bickZero93/ESP32-S3-Honeywell-HO-5500RE-Ventilator-Smart/docs/images/internal-installation.jpg

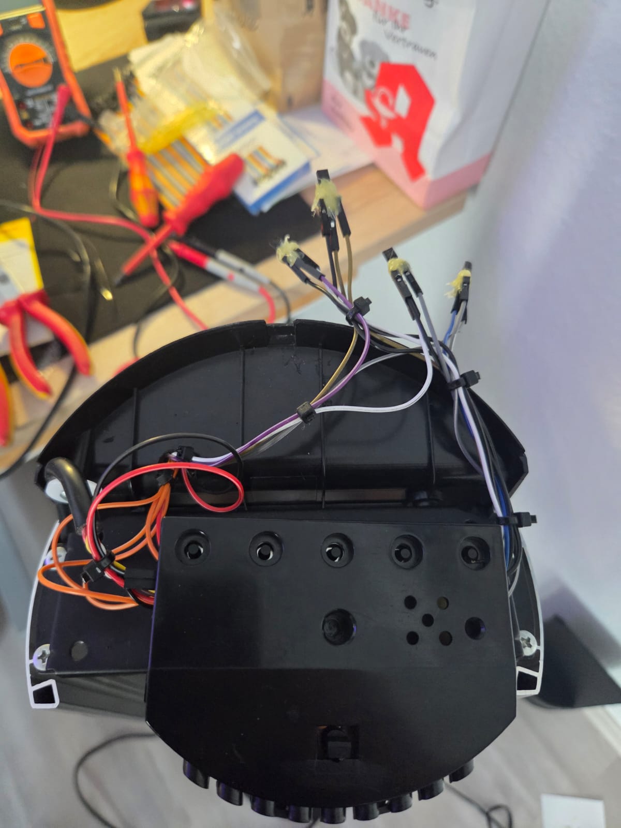
docs/images/internal-installation.jpg
