bickZero93/ESP32-S3-Honeywell-HO-5500RE-Ventilator-Smart/firmware/ventilator_esp32_s3_zero_FINAL_v6.4.10_UI_MANUAL_OSC.ino

// Smart-Ventilator / ESP32-S3-Zero
// Public GitHub build v6.4.10 - Zugangsdaten vor dem Flashen anpassen
//
// Hardware:
// GPIO6 -> 2N7000 Gate -> Taste 1 POWER    | GPIO7  <- LED Speed 1
// GPIO5 -> 2N7000 Gate -> Taste 2 SPEED    | GPIO8  <- LED Speed 2
// GPIO4 -> 2N7000 Gate -> Taste 3 OSC      | GPIO9  <- LED Speed 3
// GPIO3 -> 2N7000 Gate -> Taste 5 MODE     | GPIO10 <- LED Breeze
//                                          | GPIO1  <- LED Nacht
// Taste 4 (Original-Timer) wird NICHT benutzt.
//
// Reale Logik:
// POWER/0: normal AUS <-> AN behaelt Speed/Modus/Drehen der Fan-Platine.
// Nur nach kompletter Netztrennung startet das naechste EIN auf Speed1 / Normal / Drehen AUS.
// SPEED: 1 -> 2 -> 3 -> 1
// OSC: Toggle
// MODE: Normal -> Breeze -> Night -> Normal
//
// ACHTUNG:
// Wenn der ESP32 aus der Ventilatorplatine versorgt wird,
// USB NICHT anschliessen solange der Ventilator am Netz haengt.

#include <Arduino.h>
#include <WiFi.h>
#include <WebServer.h>
#include <Update.h>
#include <ESPmDNS.h>
#include <Preferences.h>
#include <LittleFS.h>
#include <stdarg.h>   // fuer anaSetAction (va_list)
#include <esp_system.h>

const char* WIFI_SSID = "YOUR_WIFI_SSID";
const char* WIFI_PASS = "YOUR_WIFI_PASSWORD";
const char* HOSTNAME  = "ventilator";
const char* FW_VERSION = "6.4.10-FINAL-UI-MANUAL-OSC";

// Fallback-AP, damit du dich auch bei WLAN-Problemen noch verbinden kannst.
// Wird NUR gestartet, wenn die WLAN-Verbindung fehlschlaegt (siehe startNetwork).
const char* AP_SSID = "Ventilator-Setup";
const char* AP_PASS = "CHANGE_ME_AP";   // >= 8 Zeichen, sonst bleibt der AP offen!

// Zugangsdaten fuer /update. Ohne diese koennte jeder im Netz beliebige
// Firmware aufspielen - inklusive jedem, der sich auf den Fallback-AP verbindet.
const char* OTA_USER = "admin";
const char* OTA_PASS = "CHANGE_ME_OTA";

// Belegung von unten nach oben, Taste und zugehoerige LED liegen sich
// auf dem ESP32-S3-Zero direkt gegenueber:
//   GP6 T1 Power   <->  GP7  LED Speed 1
//   GP5 T2 Speed   <->  GP8  LED Speed 2
//   GP4 T3 Drehen  <->  GP9  LED Speed 3
//   GP3 T5 Modus   <->  GP10 LED Breeze
//                       GP1  LED Nacht (links oben, ADC1 reicht nur bis GP10)
constexpr uint8_t PIN_POWER = 6;
constexpr uint8_t PIN_SPEED = 5;
constexpr uint8_t PIN_OSC   = 4;
constexpr uint8_t PIN_MODE  = 3;   // Strapping-Pin: 100k von Gate nach GND vorsehen

constexpr uint16_t PRESS_MS = 180;
constexpr uint16_t GAP_MS   = 260;

#define ENABLE_LED_FEEDBACK 1
#if ENABLE_LED_FEEDBACK
// Alle Feedback-Pins MUESSEN auf ADC1 liegen (GP1..GP10). ADC2 (ab GP11)
// ist bei aktivem WLAN vom Funkteil belegt und liefert keine Messwerte.
constexpr uint8_t PIN_LED1_FB = 7;   // LED1 ANODE / Speed 1
constexpr uint8_t PIN_LED2_FB = 8;   // LED2 ANODE / Speed 2
constexpr uint8_t PIN_LED3_FB = 9;   // LED3 ANODE / Speed 3
constexpr uint8_t PIN_LED8_FB = 10;  // Breeze
constexpr uint8_t PIN_LED9_FB = 1;   // Night
#endif

WebServer server(80);
Preferences prefs;

// Individuelle Schwellwerte fuer die 5 genutzten Feedback-LEDs.
// Reihenfolge: LED1, LED2, LED3, LED8, LED9
constexpr int FB_DEFAULT_THR[5] = {2368,3072,2432,3200,2752};
int fbThresholds[5] = {2368,3072,2432,3200,2752};

// Finale phasenunabhaengige ADC-Erfassung.
// Der alte feste Takt konnte sich mit dem LED-Multiplex synchronisieren.
// JITTER_V6 variiert Startphase, Kanalstart, Richtung, Zyklusabstand und Serienzeit.
// Die Zufallsfolge ist absichtlich nur pseudozufaellig: fuer Phasenentkopplung
// reicht das vollstaendig und die ADC-Messung bleibt frei von RNG-Nebenwirkungen.
constexpr uint8_t CAL_SAMPLER_VERSION = 6;
constexpr uint16_t PROFILE_SAMPLE_CYCLES = 480;
constexpr uint16_t PROFILE_JITTER_MIN_US = 80;
constexpr uint16_t PROFILE_JITTER_MAX_US = 420;

// FINAL_EFFICIENT_BALANCED_V6:
// Zehn feste, histogrammkompatible CDF-Schwellen pro Kanal. Ein einzelner
// Schwellwert bei ~3.1 V war in der realen Messung zu grob: mehrere 18P-
// Zustaende lagen trotz stabiler Einzelprofile fast uebereinander.
// Die 10 CDF-Stuetzstellen erfassen nun die VerteilungsFORM jedes LED-Signals.
constexpr uint8_t RICH_CDF_LEVELS = 10;
constexpr uint16_t RICH_CDF_ADC[RICH_CDF_LEVELS] = {
  1536,1792,2048,2304,2560,2816,3072,3328,3584,3840
};

// Mehrere kurze Jitter-Fenster werden absichtlich ueber einige Sekunden
// verteilt. Das mittelt Breeze/Night-Zyklen und mechanische Drehen-Effekte,
// statt zufaellig nur eine kurze Phase zu erwischen.
constexpr uint16_t PROFILE_SERIES_GAP_MIN_MS = 330;
constexpr uint16_t PROFILE_SERIES_GAP_MAX_MS = 620;

inline uint32_t profileRand32(uint32_t& x);

inline uint16_t profileSeriesGapMs(uint32_t& rng) {
  uint32_t r=profileRand32(rng);
  return PROFILE_SERIES_GAP_MIN_MS +
         (uint16_t)(r % (PROFILE_SERIES_GAP_MAX_MS-PROFILE_SERIES_GAP_MIN_MS+1));
}

inline uint32_t profileRand32(uint32_t& x) {
  x ^= x << 13;
  x ^= x >> 17;
  x ^= x << 5;
  if(x==0)x=0xA341316Cu;
  return x;
}

uint32_t profileSeedCounter=0x6D2B79F5u;

inline uint32_t profileNewSeed(uint32_t salt=0) {
  // Kein Hardware-RNG waehrend der ADC-Erfassung: wir brauchen keine
  // kryptographische Zufallsquelle, sondern nur immer neue Phasenlagen.
  profileSeedCounter += 0x9E3779B9u;
  uint32_t s=profileSeedCounter ^ (uint32_t)micros() ^
             ((uint32_t)millis()<<11) ^ salt;
  return profileRand32(s);
}

inline uint16_t profileJitterUs(uint32_t& rng) {
  uint32_t r=profileRand32(rng);
  return PROFILE_JITTER_MIN_US +
         (uint16_t)(r % (PROFILE_JITTER_MAX_US-PROFILE_JITTER_MIN_US+1));
}



struct FanState {
  uint8_t speed = 0;        // aktueller Zustand: 0=Aus, 1..3
  bool osc = false;
  uint8_t mode = 0;         // 0=Normal,1=Breeze,2=Night
  uint16_t sleepMin = 0;

  // Wird beim Ausschalten NICHT vergessen:
  uint8_t lastSpeed = 1;
  bool lastOsc = false;
  uint8_t lastMode = 0;
} state;

// Custom types bewusst sehr frueh deklarieren.
// Arduino erzeugt bei .ino-Dateien automatisch Funktionsprototypen; stehen
// solche Typen erst spaeter, kann daraus "'FbStats' does not name a type" werden.
struct FbStats {
  int minv;
  int maxv;
  int avg;
  int rangev;
  float abovePct;
  float belowPct;
  float cdfPct[RICH_CDF_LEVELS]; // Anteil >= RICH_CDF_ADC[q]
};

struct LearnedProfile {
  float avgPct[5];
  float avgMean[5];
  bool valid;
};

// -----------------------------------------------------------------
// ARDUINO-.INO-AUTOPROTOTYPE-FIREWALL
// Alle Funktionen mit eigenen Typen werden hier explizit deklariert.
// Dadurch muss der Arduino-Preprocessor fuer diese Signaturen KEINE
// automatischen Prototypen vor FbStats/LearnedProfile erzeugen.
// -----------------------------------------------------------------
inline void normalizedMeanFeature(const float meanv[5],float out[5]);
inline void normalizedMeanFeature(const FbStats cur[5],float out[5]);
inline float rawLevelFeature(const float meanv[5]);
inline float rawLevelFeature(const FbStats cur[5]);

bool addDiagnosticSampleAndAverage(const FbStats sample[5],
                                   FbStats avg[5],
                                   uint8_t minWindows);
void sampleProfileWindow(FbStats cur[5]);
void sampleProfileAverage(FbStats cur[5],uint8_t windows,uint16_t pauseMs);

bool learnProfile(LearnedProfile& p);
float currentNormalizedMean(const FbStats current[5],int ch);
float signatureDistanceWeighted(const LearnedProfile& sig,
                                const FbStats current[5],
                                const float weights[5]);
int detectProfilesWeightedFromCurrent(LearnedProfile profiles[3],
                                      const FbStats cur[5],
                                      const float weights[5],
                                      float* confidenceOut);
int detectProfilesFromCurrent(LearnedProfile profiles[3],
                              const FbStats cur[5],
                              float* confidenceOut);
int detectProfiles(LearnedProfile profiles[3],float* confidenceOut);
int detectCombo(const FbStats cur[5],
                int* speedOut,int* modeOut,
                float* speedConfOut,float* modeConfOut);
int detectComboOsc(const FbStats cur[5],
                   int* speedOut,int* modeOut,int* oscOut,
                   float* speedConfOut,float* modeConfOut,float* oscConfOut);
float comboDistanceToProfile(const LearnedProfile& p,const FbStats cur[5]);
float comboRichDistanceToState(int sp,int md,int os,const FbStats cur[5]);
float comboOscLinearScore(int sp,int md,const FbStats cur[5]);
int comboOscLinearDetect(int sp,int md,const FbStats cur[5],float* confidenceOut);
float comboPctShapeDistanceToProfile(const LearnedProfile& p,const FbStats cur[5]);
float comboPctShapeDistanceToSpeedMode(int sp,int md,const FbStats cur[5]);
int detectSpeedPctShapeForMode(int md,const FbStats cur[5],float* confidenceOut,float* fitOut);
int detectModePctShapeForSpeed(int sp,const FbStats cur[5],float* confidenceOut,float* fitOut);
void manualSyncAccumulateBatch(const FbStats cur[5],float pairDist[3][3],uint8_t speedVotes[3][3],uint8_t oscOnVotes[3][3],uint8_t oscOffVotes[3][3],float oscScoreSum[3][3]);
void detectContextual18(const FbStats cur[5],
                        int* sp,float* sc,int* md,float* mc,int* os,float* oc);
bool ledsLookOff(const FbStats cur[5]);
int anaClassifyStats(const FbStats cur[5],float* marginOut,float* fitOut);
bool anaSampleProfileAverageResponsive(FbStats cur[5],uint8_t windows,uint32_t salt);
void anaProfileRawMean(uint8_t c,float meanv[5]);

bool anaResponsiveDelay(unsigned long ms);
void anaServiceIo();
bool anaMoveToState(uint8_t sp,uint8_t md,bool os);

unsigned long timerDeadlineMs = 0;

uint32_t stateRevision=1;
uint32_t bootSessionId=0;

inline void bumpStateRevision() {
  stateRevision++;
  if(stateRevision==0)stateRevision=1;
}

uint32_t timerRemainingSec() {
  if(!timerDeadlineMs)return 0;
  long remain=(long)(timerDeadlineMs-millis());
  return remain>0?(uint32_t)((remain+999L)/1000L):0;
}


unsigned long lastWifiRetryMs = 0;

// Aktueller Power-Zustand getrennt von der gemerkten Geschwindigkeit.
bool fanIsOn = false;

// Direkt nach Power-EIN ist LED-Feedback besonders wichtig, um den vom
// Ventilator selbst gespeicherten Zustand wieder zu erkennen.
unsigned long startupSyncUntilMs = 0;
unsigned long startupSyncReadyMs = 0;
uint8_t startupSpeedCandidate = 0;
uint8_t startupSpeedHits = 0;
int8_t startupModeCandidate = -1;
uint8_t startupModeHits = 0;

bool manualLedSyncRequested = false;
bool suppressFanStateSave=false;   // nur waehrend finaler Analyse
bool suppressCalibrationSave=false; // beim atomaren Modellaufbau nur einmal am Ende schreiben

// LED-Erkennung ist reine Diagnose, ausser beim bewusst manuellen Sync.
// Nach Power-EIN warten wir, bis die Multiplexsignale stabil sind.
unsigned long ledDetectReadyMs = 0;
constexpr unsigned long LED_DETECT_SETTLE_MS = 5000UL;

int diagSpeedCandidate = 0;
uint8_t diagSpeedHits = 0;
int diagModeCandidate = -1;
uint8_t diagModeHits = 0;
int stableDiagSpeed = 0;
int stableDiagMode = -1;
float stableDiagSpeedConf = 0.0f;
float stableDiagModeConf = 0.0f;

int diagOscCandidate = -1;
uint8_t diagOscHits = 0;
int stableDiagOsc = -1;
float stableDiagOscConf = 0.0f;

constexpr uint8_t DIAG_ROLLING_WINDOWS = 10;
FbStats diagWindow[DIAG_ROLLING_WINDOWS][5];
uint8_t diagWindowCount=0;
uint8_t diagWindowPos=0;

bool diagCacheValid=false;
bool diagCachePctValid=false;
bool diagCacheOff=false;
int diagCacheSpeed=0;
int diagCacheMode=-1;
int diagCacheOsc=-1;
float diagCacheSpeedConf=0.0f;
float diagCacheModeConf=0.0f;
float diagCacheOscConf=0.0f;
float diagContextFit=0.0f;
float diagWebFit=0.0f;

// Globaler, kontextfreier 18P-Treffer.
int diagGlobalSpeed=0;
int diagGlobalMode=-1;
int diagGlobalOsc=-1;
float diagGlobalSpeedConf=0.0f;
float diagGlobalModeConf=0.0f;
float diagGlobalOscConf=0.0f;
float diagGlobalFit=0.0f;

float diagCachePct[5]={0,0,0,0,0};
unsigned long diagLastSampleMs=0;
unsigned long diagNextSampleMs=0;
uint32_t diagSeriesRng=0xD1A64C5Fu;
unsigned long diagCacheAtMs=0;
bool startupScanDone = false;

bool otaInProgress=false;
bool otaUploadSucceeded=false;


void saveFanState();

void loadFanState() {
  prefs.begin("fanstate", true);

  uint8_t savedSpeed=prefs.getUChar("lastSpeed",1);
  bool savedOsc=prefs.getBool("lastOsc",false);
  uint8_t savedMode=prefs.getUChar("lastMode",0);
  bool savedPower=prefs.getBool("powerOn",false);

  prefs.end();

  if(savedSpeed<1||savedSpeed>3)savedSpeed=1;
  if(savedMode>2)savedMode=0;

  esp_reset_reason_t reason=esp_reset_reason();
  bool realPowerCycle=(reason==ESP_RST_POWERON)||(reason==ESP_RST_BROWNOUT);

  state.sleepMin=0;
  timerDeadlineMs=0;

  if(realPowerCycle) {
    // Bei echter Netztrennung setzt auch die Ventilatorplatine zurueck:
    // physisch AUS; der naechste Start ist Stufe1 / Normal / Drehen AUS.
    fanIsOn=false;
    state.speed=0;
    state.osc=false;
    state.mode=0;
    state.lastSpeed=1;
    state.lastOsc=false;
    state.lastMode=0;
    saveFanState();
    Serial.println("[BOOT] echter Power-Cycle -> physisch AUS, Basis St1/Normal/Drehen AUS");
  } else {
    // Bei OTA-/Software-Neustart bleibt die Ventilatorplatine in Betrieb.
    // Deshalb muss nicht nur der letzte Modus, sondern auch EIN/AUS erhalten
    // bleiben; sonst wuerde die Weboberflaeche einen laufenden Fan als AUS zeigen.
    state.lastSpeed=savedSpeed;
    state.lastOsc=savedOsc;
    state.lastMode=savedMode;
    fanIsOn=savedPower;

    if(fanIsOn) {
      state.speed=savedSpeed;
      state.osc=savedOsc;
      state.mode=savedMode;
      Serial.printf("[BOOT] Software-Neustart -> Zustand erhalten: Stufe %u / Modus %u / Drehen %s\n",
                    state.speed,state.mode,state.osc?"AN":"AUS");
    } else {
      state.speed=0;
      state.osc=false;
      state.mode=0;
    }
  }
}

void saveFanState() {
  prefs.begin("fanstate",false);
  prefs.putUChar("lastSpeed",state.lastSpeed);
  prefs.putBool("lastOsc",state.lastOsc);
  prefs.putUChar("lastMode",state.lastMode);
  prefs.putBool("powerOn",fanIsOn);
  prefs.end();
}


#if ENABLE_LED_FEEDBACK
const uint8_t FB_USED_PINS[5] = {
  PIN_LED1_FB, PIN_LED2_FB, PIN_LED3_FB, PIN_LED8_FB, PIN_LED9_FB
};

LearnedProfile speedSig[3];  // Speed 1..3
LearnedProfile modeSig[3];   // Normal, Breeze, Night
// AUS wird gemessen statt geschaetzt. Bei gemultiplexten LEDs liegt der
// Aus-Pegel nicht zwingend weit genug unter den Ein-Profilen, deshalb
// reicht eine feste Prozentgrenze nicht aus.
LearnedProfile offSig;

// Neun Profile: eine eigene Signatur je Stufe/Modus-Kombination.
// Grund: Die Messung zeigt, dass sich das Muster eines Modus staerker
// zwischen den Stufen verschiebt (3,3) als Breeze von Nacht abweicht (0,3).
// Ein ueber die Stufen gemitteltes Modus-Profil passt damit zu keinem
// tatsaechlichen Zustand. comboSig[speed-1][mode] loest das.
LearnedProfile comboSig[3][3];

// Finale 18 Profile: Speed (3) x Modus (3) x Drehen (2).
// Der integrierte Drehen-Test hat gezeigt: 7/9 Zustaende wurden mit
// Drehen AN durch die alte 9-Profil-Erkennung falsch klassifiziert,
// groesster Driftfaktor 6.10. Deshalb ist Oscillation jetzt eine echte
// dritte Klassifikationsdimension und kein externer Diagnosetest mehr.
LearnedProfile comboOscSig[3][3][2];

bool calibrationSamplerCurrent=false; // nur FINAL_EFFICIENT_BALANCED_V6-Profile duerfen als aktuelle Generation gelten
bool compactComboLoaded = false;
bool compactComboLastSaveOk = false;

bool comboOscComplete() {
  for(int sp=0; sp<3; sp++)
    for(int md=0; md<3; md++)
      for(int os=0; os<2; os++)
        if(!comboOscSig[sp][md][os].valid) return false;
  return true;
}

uint8_t comboOscValidCount() {
  uint8_t n=0;
  for(int sp=0;sp<3;sp++)
    for(int md=0;md<3;md++)
      for(int os=0;os<2;os++)
        if(comboOscSig[sp][md][os].valid)n++;
  return n;
}

uint8_t comboValidCount() {
  uint8_t n=0;
  for(int sp=0;sp<3;sp++)
    for(int md=0;md<3;md++)
      if(comboSig[sp][md].valid)n++;
  return n;
}

// Diese beiden Flags muessen vor activeRecognitionModel() sichtbar sein.
bool comboRichValid=false;
bool comboGlobalSyncSafe=false;

const char* activeRecognitionModel() {
  if(!calibrationSamplerCurrent) return "NEUKALIBRIERUNG";
  if(comboOscComplete() && comboRichValid) return "FINAL_18P";
  if(comboValidCount()==9) return "FALLBACK_9P";
  return "EINZELPROFILE";
}

// Aus der Messung abgeleitete Kanalgewichte. Statt fester Zahlen bekommt
// jeder Kanal das Gewicht, das seinem Signal-Rausch-Verhaeltnis entspricht:
// Spannweite zwischen den Zustaenden geteilt durch die Streuung innerhalb
// eines Zustands. Kanaele, die nichts beitragen, fallen so von selbst weg.
float comboW[5] = {1.0f,1.0f,1.0f,1.0f,1.0f};
bool  comboWValid = false;

// Formanteil der Distanzberechnung (0 = nur Absolutpegel, 1 = nur Form).
// Hintergrund: Breeze und Nacht liegen im Pegel praktisch gleichauf, LED8
// ist im Nacht-Modus aber konsistent niedriger und LED9 hoeher. Diese
// Formdifferenz ueberlebt, wenn man den Mittelwert ueber alle Kanaele
// abzieht - und weil das Rauschen gemultiplexter LEDs weitgehend
// gleichtaktig ist, faellt es dabei mit heraus.
// Der Wert wird im Messlauf ermittelt, nicht geraten.
float comboShape = 0.0f;

// Zweites, explizit mitkalibriertes Merkmal: relative ADC-Mittelwerte.
// Diese Information ist besonders fuer die historisch enge Stufe-1/Stufe-3-
// Trennung nuetzlich. Anders als in alten 6.0.x-Versionen wird ihr Anteil
// NICHT geraten, sondern per Cross-Validation optimiert.
float comboMeanW[5]={1.0f,1.0f,1.0f,1.0f,1.0f};
float comboMeanAlpha=0.0f;

// 50 CDF-Merkmale (5 Kanaele x 10 Pegel), kompakt quantisierte 18P-Zentren.
// uint16_t speichert 0.01 Prozentpunkte (0..10000) ohne relevante Quantisierungsverluste.
float comboRichW[5][RICH_CDF_LEVELS] = {};
uint16_t comboRichPctQ[3][3][2][5][RICH_CDF_LEVELS] = {};
float comboLevelAlpha=0.0f;

// Dedizierter Drehen-Klassifikator V1.
// Der reale 6.4.3-Lauf zeigte: Speed und Modus sind mit dem Rich-Modell
// eindeutig, waehrend Drehen in Breeze/Nacht nicht durch eine gemeinsame
// 18P-Metrik stabil genug ist. Deshalb wird Drehen bei bekanntem Modus
// mode-uebergreifend ueber alle drei Stufen als lineares CDF-Modell erkannt.
// Features: 5 Kanaele x 10 CDF-Pegel + 3 Speed-One-Hot = 53.
constexpr uint8_t OSC_LINEAR_FEATURES=53;
int16_t comboOscLinW[3][OSC_LINEAR_FEATURES] = {};
float comboOscLinScale[3]={1.0f,1.0f,1.0f};
float comboOscLinBias[3]={0.0f,0.0f,0.0f};
bool comboOscLinValid=false;

// Normales Tracking ist bewusst kontextuell: Webzustand = autoritativ.
// Blindes 18P wird separat bewertet und nur fuer den manuellen 3/3-Sync
// freigeschaltet, wenn sein eigener Holdout stark genug ist.

inline uint16_t richEncodePct(float v) {
  return (uint16_t)constrain((int)lroundf(constrain(v,0.0f,100.0f)*100.0f),0,10000);
}
inline float richDecodePct(uint16_t q) {
  return ((float)q)*0.01f;
}
inline float rawLevelFeature(const float meanv[5]) {
  float s=0.0f;
  for(int ch=0;ch<5;ch++)s+=constrain(meanv[ch],0.0f,4095.0f);
  return s*(100.0f/(5.0f*4095.0f));
}
inline float rawLevelFeature(const FbStats cur[5]) {
  float m[5];
  for(int ch=0;ch<5;ch++)m[ch]=(float)cur[ch].avg;
  return rawLevelFeature(m);
}

// Typischer maximaler Abstand eines korrekten Holdout-Treffers.
// Laufzeitmessungen weit ausserhalb dieses Bereichs werden als
// "ausserhalb Kalibrierung" erkannt statt mit hoher Scheinsicherheit.
float comboFitLimit=12.0f;

// Merkmalsvektor: f = pct - shape * Mittelwert(pct). shape=0 laesst den
// Absolutpegel unveraendert, shape=1 zentriert vollstaendig auf die Form.
inline void comboFeature(const float pct[5], float shape, float out[5]) {
  float m = 0.0f;
  for(int i=0;i<5;i++) m += pct[i];
  m /= 5.0f;
  for(int i=0;i<5;i++) out[i] = pct[i] - shape * m;
}


inline void normalizedMeanFeature(const float meanv[5],float out[5]) {
  float sum=0.0f;
  for(int ch=0;ch<5;ch++)sum+=max(meanv[ch],0.0f);
  if(sum<1.0f)sum=1.0f;
  for(int ch=0;ch<5;ch++)out[ch]=meanv[ch]*100.0f/sum;
}

inline void normalizedMeanFeature(const FbStats cur[5],float out[5]) {
  float m[5];
  for(int ch=0;ch<5;ch++)m[ch]=(float)cur[ch].avg;
  normalizedMeanFeature(m,out);
}



// Vorwaertsdeklaration bewusst vor allen Kalibrierungs-Save-Helfern.
bool saveCompactComboCalibration(bool reclaimLegacy=true);

void loadFeedbackThresholds() {
  prefs.begin("fanfb", true);
  for(int i=0;i<5;i++) {
    String key = "th" + String(i);
    fbThresholds[i] = prefs.getInt(key.c_str(), FB_DEFAULT_THR[i]);
  }
  prefs.end();
}

void saveFeedbackThreshold(int index,int value) {
  if(index<0||index>=5)return;
  fbThresholds[index]=constrain(value,0,4095);

  if(!suppressCalibrationSave)
    saveCompactComboCalibration(false);
}
#endif

// Explizite Deklarationen verhindern Probleme mit der Arduino-.ino-Autoprototypisierung.
bool learnProfile(LearnedProfile& p);
bool learnSpeedSignature(int speedNo);

// true, solange ein manueller Lernvorgang laeuft. Verhindert, dass Analyse und
// Einzel-Lernen gleichzeitig den Ventilator steuern und messen.
bool learnBusy = false;
bool learnModeSignature(int modeNo);
bool loadCompactComboCalibration();
bool saveCompactComboCalibration(bool reclaimLegacy);
void clearCompactComboCalibration();
void resetStableDiagnostic();
void armLedDiagnostic(unsigned long settleMs);
void resetDiagnosticWindow();
bool addDiagnosticSampleAndAverage(const FbStats sample[5], FbStats avg[5], uint8_t minWindows);
void sampleProfileWindow(FbStats cur[5]);
void sampleProfileAverage(FbStats cur[5], uint8_t windows, uint16_t pauseMs);
void updateLedDiagnosticTask();
void invalidateRuntimeCalibrationForSampler();
bool anaResponsiveDelay(unsigned long ms);
bool anaNormalizePhysicalBaseline(String& err);
void detectContextual18(const FbStats cur[5], int* sp,float* sc,int* md,float* mc,int* os,float* oc);
float signatureDistance5(const LearnedProfile& sig, const FbStats current[5]);
int detectProfiles(LearnedProfile profiles[3], float* confidenceOut);
int detectProfilesFromCurrent(LearnedProfile profiles[3], const FbStats cur[5], float* confidenceOut);
float normalizedMean(const float means[5], int ch);
float currentNormalizedMean(const FbStats current[5], int ch);
float signatureDistanceWeighted(const LearnedProfile& sig, const FbStats current[5], const float weights[5]);
float comboDistanceToProfile(const LearnedProfile& p,const FbStats cur[5]);
float comboFitQualityPct(float distanceSq);
float comboPctShapeDistanceToProfile(const LearnedProfile& p,const FbStats cur[5]);
float comboPctShapeDistanceToSpeedMode(int sp,int md,const FbStats cur[5]);
int detectSpeedPctShapeForMode(int md,const FbStats cur[5],float* confidenceOut,float* fitOut);
int detectModePctShapeForSpeed(int sp,const FbStats cur[5],float* confidenceOut,float* fitOut);
void manualSyncAccumulateBatch(const FbStats cur[5],float pairDist[3][3],uint8_t speedVotes[3][3],uint8_t oscOnVotes[3][3],uint8_t oscOffVotes[3][3],float oscScoreSum[3][3]);
void resetDiagnosticWindow() {
  diagWindowCount=0;
  diagWindowPos=0;
}

bool addDiagnosticSampleAndAverage(const FbStats sample[5],
                                   FbStats avg[5],
                                   uint8_t minWindows) {
  minWindows=constrain(minWindows,(uint8_t)1,(uint8_t)DIAG_ROLLING_WINDOWS);

  for(int ch=0;ch<5;ch++)diagWindow[diagWindowPos][ch]=sample[ch];
  diagWindowPos=(diagWindowPos+1)%DIAG_ROLLING_WINDOWS;
  if(diagWindowCount<DIAG_ROLLING_WINDOWS)diagWindowCount++;

  if(diagWindowCount<minWindows)return false;

  // Exakt die letzten mode-/osc-abhaengigen Fenster mitteln.
  uint8_t start=(uint8_t)((diagWindowPos+DIAG_ROLLING_WINDOWS-minWindows)%DIAG_ROLLING_WINDOWS);

  for(int ch=0;ch<5;ch++) {
    double mean=0.0,pct=0.0;
    double cdf[RICH_CDF_LEVELS] = {};
    int minv=4095,maxv=0;

    for(uint8_t k=0;k<minWindows;k++) {
      uint8_t i=(uint8_t)((start+k)%DIAG_ROLLING_WINDOWS);
      mean+=diagWindow[i][ch].avg;
      pct+=diagWindow[i][ch].abovePct;
      for(int q=0;q<RICH_CDF_LEVELS;q++)cdf[q]+=diagWindow[i][ch].cdfPct[q];
      if(diagWindow[i][ch].minv<minv)minv=diagWindow[i][ch].minv;
      if(diagWindow[i][ch].maxv>maxv)maxv=diagWindow[i][ch].maxv;
    }

    avg[ch].avg=(int)(mean/minWindows+0.5);
    avg[ch].abovePct=(float)(pct/minWindows);
    avg[ch].belowPct=100.0f-avg[ch].abovePct;
    for(int q=0;q<RICH_CDF_LEVELS;q++)avg[ch].cdfPct[q]=(float)(cdf[q]/minWindows);
    avg[ch].minv=minv;
    avg[ch].maxv=maxv;
    avg[ch].rangev=maxv-minv;
  }
  return true;
}

// Laufzeitmessung passend zur FINAL_EFFICIENT_BALANCED_V6-Kalibrierung.
// Kalibrierung und Runtime nutzen dieselbe phasenentkoppelte Verteilung.
void sampleProfileWindow(FbStats cur[5]) {
  const uint8_t pins[5]={
    PIN_LED1_FB,PIN_LED2_FB,PIN_LED3_FB,PIN_LED8_FB,PIN_LED9_FB
  };

  double sum[5]={0,0,0,0,0};
  uint32_t above[5]={0,0,0,0,0};
  uint32_t richAbove[5][RICH_CDF_LEVELS] = {};
  int minv[5]={4095,4095,4095,4095,4095};
  int maxv[5]={0,0,0,0,0};

  uint32_t rng=profileNewSeed(0x13579BDFu);
  delayMicroseconds((uint16_t)(profileRand32(rng)%2001u)); // zufaellige Startphase

  for(int i=0;i<PROFILE_SAMPLE_CYCLES;i++) {
    uint32_t r=profileRand32(rng);
    int first=(int)(r%5u);
    int dir=(r&0x100u)?1:-1;

    for(int j=0;j<5;j++) {
      int ch=(first + dir*j + 10)%5;

      // Erste ADC-Lesung nach MUX-Wechsel bewusst verwerfen.
      (void)analogRead(pins[ch]);
      int v=constrain(analogRead(pins[ch]),0,4095);

      sum[ch]+=v;
      if(v>=fbThresholds[ch])above[ch]++;
      for(int q=0;q<RICH_CDF_LEVELS;q++)
        if(v>=RICH_CDF_ADC[q])richAbove[ch][q]++;
      if(v<minv[ch])minv[ch]=v;
      if(v>maxv[ch])maxv[ch]=v;
    }

    delayMicroseconds(profileJitterUs(rng));
  }

  for(int ch=0;ch<5;ch++) {
    cur[ch].avg=(int)(sum[ch]/PROFILE_SAMPLE_CYCLES+0.5);
    cur[ch].abovePct=above[ch]*100.0f/PROFILE_SAMPLE_CYCLES;
    cur[ch].belowPct=100.0f-cur[ch].abovePct;
    for(int q=0;q<RICH_CDF_LEVELS;q++)
      cur[ch].cdfPct[q]=richAbove[ch][q]*100.0f/PROFILE_SAMPLE_CYCLES;
    cur[ch].minv=minv[ch];
    cur[ch].maxv=maxv[ch];
    cur[ch].rangev=maxv[ch]-minv[ch];
  }
}

void sampleProfileAverage(FbStats cur[5], uint8_t windows, uint16_t pauseMs) {
  windows=constrain(windows,(uint8_t)1,(uint8_t)10);

  double sumMean[5]={0,0,0,0,0};
  double sumPct[5]={0,0,0,0,0};
  double sumCdf[5][RICH_CDF_LEVELS] = {};
  int minv[5]={4095,4095,4095,4095,4095};
  int maxv[5]={0,0,0,0,0};

  for(uint8_t w=0;w<windows;w++) {
    FbStats one[5];
    sampleProfileWindow(one);

    for(int ch=0;ch<5;ch++) {
      sumMean[ch]+=one[ch].avg;
      sumPct[ch]+=one[ch].abovePct;
      for(int q=0;q<RICH_CDF_LEVELS;q++)sumCdf[ch][q]+=one[ch].cdfPct[q];
      if(one[ch].minv<minv[ch])minv[ch]=one[ch].minv;
      if(one[ch].maxv>maxv[ch])maxv[ch]=one[ch].maxv;
    }

    if(w+1<windows) {
      delay(pauseMs);
      yield();
    }
  }

  for(int ch=0;ch<5;ch++) {
    cur[ch].avg=(int)(sumMean[ch]/windows+0.5);
    cur[ch].abovePct=sumPct[ch]/windows;
    cur[ch].belowPct=100.0f-cur[ch].abovePct;
    for(int q=0;q<RICH_CDF_LEVELS;q++)cur[ch].cdfPct[q]=sumCdf[ch][q]/windows;
    cur[ch].minv=minv[ch];
    cur[ch].maxv=maxv[ch];
    cur[ch].rangev=maxv[ch]-minv[ch];
  }
}


int detectLearnedSpeed(float* confidenceOut=nullptr);
int detectLearnedMode(float* confidenceOut=nullptr);
bool ledsLookOff(const FbStats cur[5]);

static const char PAGE[] PROGMEM = R"HTML(
<!DOCTYPE html><html lang="de"><head>
<meta charset="utf-8"><meta name="viewport" content="width=device-width,initial-scale=1,viewport-fit=cover">
<meta name="theme-color" content="#0d1116"><title>Ventilator</title>
<style>
:root{--bg:#0d1116;--card:#161c24;--line:#232c38;--txt:#e8edf3;--dim:#78889c;--air:#4fd1c5}
*{box-sizing:border-box;-webkit-tap-highlight-color:transparent}
body{margin:0;min-height:100dvh;background:var(--bg);color:var(--txt);
 font:400 17px/1.4 ui-rounded,-apple-system,"Segoe UI",Roboto,sans-serif;
 padding:24px 22px}
.wrap{width:100%;max-width:380px;margin:0 auto;display:flex;flex-direction:column;gap:16px}
h1{margin:0;font-size:13px;letter-spacing:.22em;text-transform:uppercase;color:var(--dim);font-weight:600}

/* ---------- Ventilator-Grafik ---------- */
.stage{position:relative;display:grid;place-items:center;padding:4px 0 0}
#fanart{width:100%;max-width:230px;height:auto;overflow:visible}
#fanart .guard{fill:none;stroke:var(--line);stroke-width:2}
#fanart .g2{stroke-width:1.2;opacity:.7}
#fanart .g3{stroke-width:1;opacity:.45}
#fanart .cage{fill:none;stroke:var(--line);stroke-width:1;opacity:.35}
#fanart .blade{fill:var(--air);fill-opacity:.13;stroke:var(--air);stroke-width:1.6;
 stroke-linejoin:round;transition:fill-opacity .3s,stroke-opacity .3s}
#fanart .hub{fill:var(--card);stroke:var(--air);stroke-width:2}
#fanart .hubdot{fill:var(--air)}
#fanart .stand{stroke:var(--line);stroke-width:5;stroke-linecap:round;fill:none}
#fanart .base{fill:var(--card);stroke:var(--line);stroke-width:2}
#fanart .w{fill:none;stroke:var(--air);stroke-width:2.5;stroke-linecap:round;opacity:0}

/* Rotor */
#blades{transform-origin:100px 92px;animation:spin var(--spin,1s) linear infinite;animation-play-state:paused}
@keyframes spin{to{transform:rotate(360deg)}}
/* Schwenken */
#head{transform-origin:100px 156px;animation:sway 7s ease-in-out infinite;animation-play-state:paused}
@keyframes sway{0%,100%{transform:rotate(-17deg)}50%{transform:rotate(17deg)}}
/* Luftstrom */
@keyframes gust{0%{opacity:0;transform:translateX(-10px) scaleX(.7)}
 25%{opacity:var(--wo,.8)}100%{opacity:0;transform:translateX(22px) scaleX(1.15)}}

#fanart[data-speed="1"]{--spin:1.15s;--gust:1.5s;--wo:.45}
#fanart[data-speed="2"]{--spin:.62s;--gust:1s;--wo:.7}
#fanart[data-speed="3"]{--spin:.3s;--gust:.62s;--wo:1}
#fanart:not([data-speed="0"]) #blades{animation-play-state:running}
#fanart[data-osc="1"] #head{animation-play-state:running}
#fanart[data-speed="0"] .blade{fill-opacity:.05;stroke-opacity:.4}
#fanart:not([data-speed="0"]) .w{animation:gust var(--gust) ease-out infinite}
#fanart .w2{animation-delay:.18s}
#fanart .w3{animation-delay:.36s}
#fanart[data-speed="1"] .w3{display:none}
@media(prefers-reduced-motion:reduce){
 #blades,#head,#fanart .w{animation:none!important}
 #fanart:not([data-speed="0"]) .w{opacity:var(--wo)}
}

/* Modus-Effekte */
#fanart[data-mode="breeze"] g.wind{animation:breathe 4.5s ease-in-out infinite}
@keyframes breathe{0%,100%{opacity:.25}45%{opacity:1}}
#fanart[data-mode="night"]{filter:brightness(.68) saturate(.75)}

/* ---------- Bedienung ---------- */
.seg{margin-top:12px;display:grid;grid-template-columns:repeat(3,1fr);gap:6px;background:var(--card);
 border:1px solid var(--line);border-radius:20px;padding:6px;transition:opacity .2s}
.seg.off{opacity:.4}
.seg button{border:none;background:none;color:var(--dim);font:600 14px/1 inherit;
 padding:12px 4px;border-radius:15px;cursor:pointer;transition:.18s}
.seg button.on{background:var(--air);color:#06231f}
.seg button:disabled{cursor:default}
.dial{display:grid;grid-template-columns:repeat(4,1fr);gap:10px;margin-bottom:2px}
.dial button{aspect-ratio:1;border:1px solid var(--line);border-radius:20px;background:var(--card);
 color:var(--dim);font:600 26px/1 inherit;display:grid;place-content:center;gap:6px;transition:.18s;cursor:pointer}
.dial button span{font-size:10px;letter-spacing:.14em;text-transform:uppercase}
.dial button.on{background:var(--air);border-color:var(--air);color:#06231f;box-shadow:0 0 26px -6px var(--air)}
.dial button:active{transform:scale(.94)}
.dial button:disabled{opacity:.5;cursor:default}
.row{display:flex;align-items:center;justify-content:space-between;gap:16px;
 background:var(--card);border:1px solid var(--line);border-radius:20px;padding:14px 20px}
.row small{display:block;color:var(--dim);font-size:13px;margin-top:2px}
.sw{width:62px;height:34px;flex:0 0 auto;border:none;border-radius:17px;background:var(--line);position:relative;transition:.2s;cursor:pointer}
.sw::after{content:"";position:absolute;top:4px;left:4px;width:26px;height:26px;border-radius:50%;background:var(--txt);transition:.2s}
.sw.on{background:var(--air)}.sw.on::after{left:32px;background:#06231f}
.sw:disabled{opacity:.35;cursor:default}

.timer{background:var(--card);border:1px solid var(--line);border-radius:20px;padding:14px 20px 8px;transition:opacity .2s}
.timer.off{opacity:.4}
.thead{display:flex;align-items:baseline;justify-content:space-between;gap:12px}
.tval{font:600 30px/1 inherit;font-variant-numeric:tabular-nums;color:var(--dim);transition:color .2s;white-space:nowrap}
.tval.on{color:var(--air)}
.tval em{font-style:normal;font-size:14px;font-weight:400;margin-left:3px;color:var(--dim)}
.trest{color:var(--dim);font-size:13px;margin-top:2px}
input[type=range]{-webkit-appearance:none;appearance:none;width:100%;margin:8px 0 0;height:34px;background:transparent;cursor:pointer}
input[type=range]:disabled{cursor:default}
input[type=range]::-webkit-slider-runnable-track{height:8px;border-radius:4px;background:var(--trk,var(--line))}
input[type=range]::-moz-range-track{height:8px;border-radius:4px;background:var(--trk,var(--line))}
input[type=range]::-webkit-slider-thumb{-webkit-appearance:none;width:26px;height:26px;margin-top:-9px;border-radius:50%;
 background:var(--knob,var(--dim));border:4px solid var(--card);box-shadow:0 2px 10px #0009;transition:transform .12s}
input[type=range]::-moz-range-thumb{width:26px;height:26px;border-radius:50%;border:4px solid var(--card);
 background:var(--knob,var(--dim));box-shadow:0 2px 10px #0009}
input[type=range]:active::-webkit-slider-thumb{transform:scale(1.18)}
.ticks{display:flex;justify-content:space-between;font-size:11px;color:var(--dim);
 letter-spacing:.06em;padding:0 2px 4px;font-variant-numeric:tabular-nums}
.sync{border:none;background:none;color:var(--dim);font:inherit;font-size:13px;text-decoration:underline;padding:2px;cursor:pointer}
.demo{border-top:1px dashed var(--line);padding-top:12px;color:var(--dim);font-size:12px;line-height:1.7}
.demo b{color:var(--txt);font-weight:600}
.demo label{display:flex;align-items:center;gap:8px;margin-top:6px;cursor:pointer}
.demo input{accent-color:var(--air);width:16px;height:16px}

/* ---------- ESP32 / Netzwerk / OTA ---------- */
.statusbar{display:flex;align-items:center;justify-content:space-between;gap:10px;
 background:var(--card);border:1px solid var(--line);border-radius:16px;padding:10px 14px;
 color:var(--dim);font-size:12px}
.statusleft,.statusright{display:flex;align-items:center;gap:8px}
.dot{width:8px;height:8px;border-radius:50%;background:var(--dim);box-shadow:0 0 0 3px #0002}
.dot.ok{background:var(--air)} .dot.err{background:#ff7373}
.badge{border:1px solid var(--line);border-radius:999px;padding:3px 8px;font-size:11px}
nav.tabs{display:grid;grid-template-columns:1fr 1fr;gap:6px;background:var(--card);
 border:1px solid var(--line);border-radius:18px;padding:5px;margin:14px 0 4px;position:sticky;top:8px;z-index:5}
nav.tabs button{border:none;background:none;color:var(--dim);font:600 14px/1 inherit;
 padding:12px 4px;border-radius:13px;cursor:pointer;transition:.18s}
nav.tabs button.on{background:var(--air);color:#06231f}
section[hidden]{display:none}
#viewCfg:not([hidden]){display:flex;flex-direction:column;gap:14px}
#viewMain:not([hidden]){display:block}
a.panellink{display:flex;align-items:center;justify-content:space-between;gap:12px;
 background:var(--card);border:1px solid var(--line);border-radius:20px;padding:16px;
 color:var(--txt);text-decoration:none;font-weight:600;font-size:15px}
a.panellink span{color:var(--dim);font-weight:400;font-size:13px;display:block;margin-top:3px}
a.panellink i{color:var(--air);font-style:normal;font-size:20px}
.dial button.on:disabled,.seg button.on:disabled{opacity:1}
.dial button.pending,.seg button.pending,.sw.pending{animation:pend 1.1s ease-in-out infinite}
@keyframes pend{50%{opacity:.55}}
details.panel{background:var(--card);border:1px solid var(--line);border-radius:20px;padding:0 16px;
 overflow:hidden;flex:0 0 auto}
details.panel>summary{cursor:pointer;list-style:none;padding:14px 0;font-size:14px;font-weight:600}
details.panel>summary::-webkit-details-marker{display:none}
.panelbody{border-top:1px solid var(--line);padding:12px 0 15px;color:var(--dim);font-size:13px}
.grid2{display:grid;grid-template-columns:1fr 1fr;gap:8px}
.kv{background:#10161d;border:1px solid var(--line);border-radius:13px;padding:9px 10px}
.kv b{display:block;color:var(--txt);font-size:12px;margin-bottom:2px}
.mini{border:1px solid var(--line);background:#10161d;color:var(--txt);border-radius:10px;padding:7px 10px;font:inherit;font-size:12px;cursor:pointer}
.upload{display:flex;gap:8px;align-items:center;flex-wrap:wrap;margin-top:10px}
.upload input[type=file]{max-width:100%;font-size:12px}
.note{font-size:11px;line-height:1.45;color:var(--dim);margin-top:8px}
.warn{border:1px solid #805f27;background:#2a2114;border-radius:14px;padding:10px 12px;color:#d8c18c;font-size:11px;line-height:1.45}

/* ---------- Manuelle Web-Status-Korrektur ---------- */
.manual-card{background:var(--card);border:1px solid var(--line);border-radius:20px;overflow:hidden}
.manual-details>summary{list-style:none;cursor:pointer;display:flex;align-items:flex-start;
 justify-content:space-between;gap:12px;padding:15px}
.manual-details>summary::-webkit-details-marker{display:none}
.manual-details>summary::after{content:"⌄";color:var(--dim);font-size:18px;line-height:1;
 margin-left:6px;transition:.18s}
.manual-details[open]>summary::after{transform:rotate(180deg)}
.manual-details>summary b{font-size:14px}
.manual-details>summary span{display:block;color:var(--dim);font-size:11px;margin-top:2px}
.manual-status{color:var(--air)!important;font-size:11px!important;white-space:nowrap;
 padding-top:2px;margin-left:auto}
.manual-body{border-top:1px solid var(--line);padding:12px 15px 15px}
.manual-buttons{display:grid;grid-template-columns:repeat(4,1fr);gap:7px}
.manual-buttons button,.manual-modes button{border:1px solid var(--line);background:#10161d;color:var(--txt);
 border-radius:12px;padding:11px 4px;font:600 12px/1 inherit;cursor:pointer}
.manual-buttons button.on,.manual-modes button.on{background:var(--air);border-color:var(--air);color:#06231f}
.manual-buttons button:disabled,.manual-modes button:disabled{opacity:.5;cursor:default}
.manual-buttons button:active,.manual-modes button:active{transform:scale(.97)}
.manual-mode-label{margin:12px 2px 7px;color:var(--dim);font-size:11px;text-transform:uppercase;
 letter-spacing:.12em}
.manual-modes{display:grid;grid-template-columns:repeat(3,1fr);gap:7px}
.manual-osc-row{display:flex;align-items:center;justify-content:space-between;gap:14px;
 background:#10161d;border:1px solid var(--line);border-radius:12px;padding:10px 12px}
.manual-osc-row b{display:block;color:var(--txt);font-size:12px}
.manual-osc-row span{display:block;color:var(--dim);font-size:10px;margin-top:2px}
.sync-wide{width:100%;padding:12px 14px;border-radius:13px;font-weight:600}

/* ---------- Einstellungen kompakt gruppiert ---------- */
.grouped-tools{display:flex;flex-direction:column;gap:10px}
.tool-block{background:#10161d;border:1px solid var(--line);border-radius:14px;padding:11px}
.tool-head{display:flex;align-items:center;justify-content:space-between;gap:12px}
.tool-head b{display:block;color:var(--txt);font-size:13px}
.tool-head span{display:block;color:var(--dim);font-size:11px;margin-top:2px}
.tool-link{color:inherit;text-decoration:none}
.calibration-subpanel{padding:0;overflow:hidden}
.calibration-subpanel>summary{list-style:none;cursor:pointer;padding:11px}
.calibration-subpanel>summary::-webkit-details-marker{display:none}
.calibration-subpanel>summary::after{content:"⌄";color:var(--dim);font-size:18px;margin-left:8px}
.calibration-subpanel[open]>summary::after{transform:rotate(180deg)}
.calibration-subpanel>.note{padding:0 11px}
.calibration-subpanel>.panelbody{margin:0 11px;padding-bottom:11px}

</style></head><body>
<div class="wrap">
<h1 id="hdr">Aus</h1>
<div class="statusbar">
 <div class="statusleft"><span class="dot" id="connDot"></span><span id="connTxt">ESP32 wird gesucht…</span></div>
 <div class="statusright"><span class="badge" id="fwBadge">FW —</span></div>
</div>

<nav class="tabs">
 <button id="tabMain" class="on" type="button">Steuerung</button>
 <button id="tabCfg" type="button">Einstellungen</button>
</nav>

<section id="viewMain">
<div class="stage">
<svg id="fanart" viewBox="0 0 200 205" data-speed="0" data-osc="0" aria-hidden="true">
 <!-- Luftstrom -->
 <g class="wind">
  <path class="w w1" d="M168 66 q16 14 0 28"/>
  <path class="w w2" d="M168 92 q20 14 0 28" style="stroke-width:3"/>
  <path class="w w3" d="M168 120 q14 12 0 24"/>
 </g>
 <!-- Fuß -->
 <path class="stand" d="M100 150 L100 182"/>
 <ellipse class="base" cx="100" cy="186" rx="30" ry="8"/>
 <!-- Kopf: schwenkt -->
 <g id="head">
  <circle class="guard" cx="100" cy="92" r="62"/>
  <circle class="guard g2" cx="100" cy="92" r="47"/>
  <circle class="guard g3" cx="100" cy="92" r="31"/>
  <path class="cage" d="M100 30 V154 M38 92 H162 M56 48 L144 136 M144 48 L56 136"/>
  <g id="blades">
   <path class="blade" id="bl" d="M100 92 C92 66 100 44 120 38 C134 56 128 80 100 92 Z"/>
   <use href="#bl" class="blade" transform="rotate(120 100 92)"/>
   <use href="#bl" class="blade" transform="rotate(240 100 92)"/>
  </g>
  <circle class="hub" cx="100" cy="92" r="12"/>
  <circle class="hubdot" cx="100" cy="92" r="4"/>
 </g>
</svg>
</div>

<div class="dial">
 <button data-s="0">0<span>An / Aus</span></button>
 <button data-s="1">1<span>Leise</span></button>
 <button data-s="2">2<span>Mittel</span></button>
 <button data-s="3">3<span>Stark</span></button>
</div>
<div class="seg off" id="modes">
 <button data-m="0" class="on">Normal</button>
 <button data-m="1">Breeze</button>
 <button data-m="2">Nacht</button>
</div>
<div class="row" style="margin-top:10px"><div>Drehen<small>Schwenkbetrieb</small></div><button id="osc" class="sw"></button></div>
<div class="timer off" id="tcard" style="margin-top:14px">
 <div class="thead">
  <div>Sleep-Timer<div class="trest" id="trest">Ventilator ist aus</div></div>
  <div class="tval" id="tval">Aus</div>
 </div>
 <input type="range" id="slp" min="0" max="240" step="5" value="0" disabled
        aria-label="Sleep-Timer in Minuten">
 <div class="ticks"><span>Aus</span><span>1h</span><span>2h</span><span>3h</span><span>4h</span></div>
</div>

<div class="upload" style="margin-top:12px">
 <button class="mini sync-wide" id="ledSync" type="button">Status über LEDs abgleichen</button>
</div>

<details class="manual-card manual-details" id="manualStatePanel" style="margin-top:12px">
 <summary>
  <div>
   <b>Web-Status manuell setzen</b>
   <span>Falls der Ventilator direkt am Gerät bedient wurde</span>
  </div>
  <div class="manual-status" id="manualState">—</div>
 </summary>
 <div class="manual-body">
  <div class="manual-buttons" id="manualSpeedButtons">
   <button data-manual-speed="0" type="button">Aus</button>
   <button data-manual-speed="1" type="button">Stufe 1</button>
   <button data-manual-speed="2" type="button">Stufe 2</button>
   <button data-manual-speed="3" type="button">Stufe 3</button>
  </div>
  <div class="manual-mode-label">Modus</div>
  <div class="manual-modes" id="manualModeButtons">
   <button data-manual-mode="0" type="button">Normal</button>
   <button data-manual-mode="1" type="button">Breeze</button>
   <button data-manual-mode="2" type="button">Nacht</button>
  </div>
  <div class="manual-mode-label">Drehen</div>
  <div class="manual-osc-row">
   <div>
    <b>Schwenkbetrieb</b>
    <span>Nur den Web-Status korrigieren</span>
   </div>
   <button id="manualOsc" class="sw" type="button" aria-label="Drehen-Status manuell setzen"></button>
  </div>
 </div>
</details>


</section>

<section id="viewCfg" hidden>

<details class="panel">
<summary>ESP32 & OTA</summary>
<div class="panelbody">
 <div class="grid2">
  <div class="kv"><b>IP-Adresse</b><span id="ip">—</span></div>
  <div class="kv"><b>WLAN</b><span id="rssi">—</span></div>
  <div class="kv"><b>Uptime</b><span id="uptime">—</span></div>
  <div class="kv"><b>Build</b><span id="build">—</span></div>
  <div class="kv"><b>Gemerkter Zustand</b><span id="remembered">—</span></div>
  <div class="kv"><b>Statusquelle</b><span id="stateSource">—</span></div>
 </div>

 <div class="note" style="margin-top:14px"><b style="color:var(--txt)">Kalibrierungsstatus</b><br>
 Hier siehst du nach Neustart oder Update sofort, ob die finale Kalibrierung geladen ist und welches Erkennungsmodell tatsächlich benutzt wird.</div>
 <div class="grid2" style="margin-top:10px">
  <div class="kv"><b>Finale Profile</b><span id="otaCal18">—</span></div>
  <div class="kv"><b>Aktives Modell</b><span id="otaModel">—</span></div>
  <div class="kv"><b>AUS-Profil</b><span id="otaOffProfile">—</span></div>
  <div class="kv"><b>9P-Fallback</b><span id="otaCal9">—</span></div>
  <div class="kv"><b>Profilspeicher</b><span id="otaStorage">—</span></div>
  <div class="kv"><b>Kalibrierungsstand</b><span id="otaCalSeq">—</span></div>
 </div>

 <form class="upload" id="otaForm">
  <input type="file" id="otaFile" accept=".bin,application/octet-stream">
  <button class="mini" type="submit">OTA installieren</button>
 </form>
 <div class="note" id="otaMsg">Spätere Firmware-Updates direkt über WLAN. Verbindungsanzeige läuft getrennt von den langsameren LED-Messungen.</div>
 <div class="warn" style="margin-top:12px">GPIO-Belegung &mdash; Tasten: T1/Power = GP6, T2/Speed = GP5, T3/Drehen = GP4, T5/Modus = GP3. LED-Feedback: Speed 1 = GP7, Speed 2 = GP8, Speed 3 = GP9, Breeze = GP10, Nacht = GP1.</div>
</div>
</details>

<details class="panel">
<summary>Kalibrierung &amp; Daten</summary>
<div class="panelbody grouped-tools">

 <div class="tool-block">
  <div class="tool-head">
   <a class="tool-link" href="/analyze">
    <b>Trennschärfe-Analyse</b>
    <span>Messprofile, Diagnose und Übernahme</span>
   </a>
   <a class="mini tool-link" href="/analyze">Öffnen</a>
  </div>
 </div>

 <details class="tool-block calibration-subpanel">
  <summary class="tool-head">
   <div>
    <b>Speed-Kalibrierung</b>
    <span>Referenzprofile, Diagnose und Fallback</span>
   </div>
  </summary>
<div class="note">Aktive Schwellwerte: <span id="thrNow">—</span><br>
Werden sie geändert, verlieren alle gelernten Profile ihre Gültigkeit und müssen
neu aufgenommen werden — egal ob einzeln oder über die Trennschärfe-Analyse.</div>
<div class="panelbody">
 <div class="note">Diese Einzelprofile sind nur Diagnose/Fallback. Das produktive FINAL-Tracking nutzt die 18 Profile. Im Hauptbetrieb <b>Normal</b> wird zusaetzlich die offset-/skalierungsfreie relative Kanalform verwendet; der Webzustand bleibt autoritativ.</div>
 
 <div class="grid2" style="margin-top:10px">
  <div class="kv"><b>Speed 1</b><span id="cal1">nicht gelernt</span></div>
  <div class="kv"><b>Speed 2</b><span id="cal2">nicht gelernt</span></div>
  <div class="kv"><b>Speed 3</b><span id="cal3">nicht gelernt</span></div>
  <div class="kv"><b>Aus-Zustand</b><span id="calOff">nicht gelernt</span></div>
  <div class="kv"><b>Kombiprofile</b><span id="calCombo">nicht gelernt</span></div>
  <div class="kv"><b>Web-Soll</b><span id="detWebState">—</span></div>
  <div class="kv"><b>LED-Pruefung Speed</b><span id="detSpeed">—</span></div>
  <div class="kv"><b>Speed Sicherheit</b><span id="detConf">—</span></div>
  <div class="kv"><b>LED-Pruefung Drehen</b><span id="detOsc">—</span></div>
  <div class="kv"><b>Drehen Sicherheit</b><span id="detOscConf">—</span></div>
  <div class="kv"><b>Tracking</b><span id="detTracking">—</span></div>
  <div class="kv"><b>Modell-Fit</b><span id="detFit">—</span></div>
  <div class="kv"><b>18P Treffer ohne Web-Kontext</b><span id="detProfile">—</span></div>
  <div class="kv"><b>Messalter</b><span id="detAge">—</span></div>
  <div class="kv"><b>Live LED-%</b><span id="detLivePct">—</span></div>
  <div class="kv"><b>Web-Soll-Profil</b><span id="detExpectedPct">—</span></div>
 </div>
 <div class="upload">
  <button class="mini" id="forgetSpeedCal" type="button">Speed-Kalibrierung löschen</button>
 </div>
 <div class="upload">
  <button class="mini" id="learn1" type="button">Speed 1 lernen</button>
  <button class="mini" id="learn2" type="button">Speed 2 lernen</button>
  <button class="mini" id="learn3" type="button">Speed 3 lernen</button>
 </div>
 <div class="note" style="margin-top:10px">Der Aus-Zustand wird ebenfalls gemessen statt geschätzt.
 Ventilator wirklich ausschalten, dann lernen — sonst erkennt „Status über LEDs abgleichen" den
 Aus-Zustand nicht und landet auf Stufe 1.</div>
 <div class="upload">
  <button class="mini" id="learnOff" type="button">Aus-Zustand lernen</button>
 </div>
 
 
 <div class="note" style="margin-top:14px"><b style="color:var(--txt)">Modus-Fallback lernen</b> — optional fuer Diagnose; das FINAL-18P-Modell bleibt unveraendert.</div>
 
 <div class="grid2" style="margin-top:10px">
  <div class="kv"><b>Normal</b><span id="calNormal">nicht gelernt</span></div>
  <div class="kv"><b>Breeze</b><span id="calBreeze">nicht gelernt</span></div>
  <div class="kv"><b>Night</b><span id="calNight">nicht gelernt</span></div>
  <div class="kv"><b>LED-Pruefung Modus</b><span id="detMode">—</span></div>
  <div class="kv"><b>Modus Sicherheit</b><span id="detModeConf">—</span></div>
 </div>
 <div class="upload">
  <button class="mini" id="forgetModeCal" type="button">Modus-Kalibrierung löschen</button>
 </div>
 <div class="upload">
  <button class="mini" id="learnNormal" type="button">Normal lernen</button>
  <button class="mini" id="learnBreeze" type="button">Breeze lernen</button>
  <button class="mini" id="learnNight" type="button">Night lernen</button>
 </div>
 
 <div class="note"><b style="color:var(--txt)">Zustandsprioritaet:</b> Webbefehle, manuelle Stufen-/Modus-/Drehen-Bedienung und der Sleep-Timer sind verbindlich. Die LED-Diagnose veraendert die Hauptanzeige nie automatisch. Die finale LED-Erkennung nutzt FINAL_EFFICIENT_BALANCED_V6: zufaellige Startphase, Kanalreihenfolge und Abtastabstaende verhindern eine Synchronisation mit dem LED-Multiplex. Die Felder „LED-Pruefung Speed/Modus/Drehen“ pruefen gezielt gegen den bewusst gesetzten Webzustand; „18P Treffer“ bleibt die komplett kontextfreie LED-Erkennung. „Status über LEDs abgleichen“ und „Web-Status manuell setzen“ dürfen den Zustand bewusst korrigieren; beide erzeugen dabei keine automatischen LED-basierten Hintergrundänderungen.</div><div class="note"><b style="color:var(--txt)">FINAL_EFFICIENT_BALANCED_V6:</b> Diese Generation kombiniert phasenentkoppelte Jitter-Abtastung, CDF-Prozentmerkmale und relative ADC-Mittelwertmuster. Alte 6.0–6.4.2-Profile/Backups und fruehere Analyse-Checkpoints sind absichtlich inkompatibel; fuer EFFICIENT-BALANCED V6 ist genau einmal der neue komplette Messlauf erforderlich.</div><div class="note"><b style="color:var(--txt)">Finale Messlogik:</b> AUS wird separat erkannt. Das FINAL-Modell klassifiziert 18 vollständige Speed × Modus × Drehen-Zustände; 9P und Einzelprofile sind nur Rückfall/Diagnose. Die LED-Diagnose überschreibt den Webzustand nie automatisch.</div><div class="note"><b style="color:var(--txt)">Manueller LED-Sync:</b> Drei unabhängige Messbatches verwenden exakt dieselbe Modus-/Drehen-abhängige Fenstertiefe wie die Hintergrunddiagnose (Normal AUS 6, Normal AN 8, dynamisch AUS 8, dynamisch AN 10). Ein frischer stabiler Diagnose-Speed wird bevorzugt; sonst entscheidet die Batch-Mehrheit und erst danach die gemittelte Formdistanz. NORMAL bleibt der Ausgangspunkt. Ein Moduswechsel weg von NORMAL oder ein widersprechender Drehen-Wechsel braucht stärkere Evidenz.</div><div class="note"><b style="color:var(--txt)">Tracking:</b> Web-Soll, Timer und Befehlszustand werden direkt nach dem Tastendruck bzw. der Serverbestätigung aktualisiert. Die LED-Diagnose läuft separat im Hintergrund; /api/status ist ADC-frei und liefert fertige Cachewerte. Dadurch bleibt die Oberfläche schnell, während die Erkennung exakt 6/8 Fenster in Normal bzw. 8/10 Fenster in Breeze/Nacht, zeitlich gespreizt mittelt.</div><div class="note" id="calMsg">Noch nichts gelernt.</div>
</div>
 </details>

 <div class="tool-block">
  <div class="tool-head">
   <div>
    <b>Backup &amp; Wiederherstellung</b>
    <span>Kalibrierung sichern oder wiederherstellen</span>
   </div>
  </div>
<div class="panelbody">
 <div class="note">Exportiert interne Messparameter, gelernte Speed-/Mode-Profile und die zuletzt gemerkten Einstellungen als JSON-Datei. Export ist erst bei einem vollstaendigen FINAL-18P-Modell freigegeben. Das JSON enthaelt Schwellen, 18P/9P-Profile, CDF- und Mean-Gewichte sowie Fit-Grenze. Nur FINAL_EFFICIENT_BALANCED_V6-Backups werden importiert.</div>
 <div class="upload">
  <button class="mini" id="backupExport" type="button">Backup exportieren</button>
  <input type="file" id="backupFile" accept=".json,application/json">
  <button class="mini" id="backupImport" type="button">Backup importieren</button>
 </div>
 <div class="note" id="backupMsg">Noch kein Backup importiert/exportiert.</div>
</div>
 </div>

</div>
</details>

</section>


</div>
<script>
let S={speed:0,osc:false,sleep:0,sleepSec:0,mode:0},busy=false,tick=null,restMin=0,online=false,calibrating=false;
let remembered={speed:1,mode:0,osc:false};
let confirmedSleepSec=0,confirmedSleepAt=Date.now();
let lastStateRevision=0,lastBootId=0,sleepSyncAt=Date.now();
const MODE=['Normal','Breeze','Nacht'],MKEY=['normal','breeze','night'];
const $=q=>document.querySelector(q);
const slp=$('#slp'), art=$('#fanart');

 const fmt=(m)=>{
 if(m<=0)return'Aus';
 if(m<60)return m+'<em>min</em>';
 return Math.floor(m/60)+':'+String(m%60).padStart(2,'0')+'<em>h</em>';
}
 const currentSleepSec=()=>{
  if(!S.sleepSec)return 0;
  return Math.max(0,Math.ceil(S.sleepSec-(Date.now()-sleepSyncAt)/1000));
}
 const fmtClock=(sec)=>{
  sec=Math.max(0,Math.round(sec)||0);
  const h=Math.floor(sec/3600),m=Math.floor((sec%3600)/60),s=sec%60;
  return h?`${h}:${String(m).padStart(2,'0')}:${String(s).padStart(2,'0')}`:`${m}:${String(s).padStart(2,'0')}`;
}
 const applyServerState=(st)=>{
  if(!st)return false;

  const boot=Number(st.bootId||0);
  if(boot && boot!==lastBootId){
    lastBootId=boot;
    lastStateRevision=0;
  }

  const rev=Number(st.revision||0);
  if(rev && rev<lastStateRevision)return false;
  if(rev)lastStateRevision=rev;

  const powerOn=!!st.powerOn;
  S.speed=powerOn?(Number(st.speed)||1):0;
  S.osc=powerOn?!!st.osc:false;
  S.mode=powerOn?(Number(st.mode)||0):0;
  S.sleep=Number(st.sleep)||0;
  S.sleepSec=Number(st.sleepSec)||0;
  sleepSyncAt=Date.now();
  confirmedSleepSec=S.sleepSec;
  confirmedSleepAt=sleepSyncAt;

  remembered.speed=Math.min(3,Math.max(1,Number(st.lastSpeed)||1));
  remembered.mode=Math.min(2,Math.max(0,Number(st.lastMode)||0));
  remembered.osc=!!st.lastOsc;

  const rem=$('#remembered');
  if(rem)rem.textContent='Speed '+remembered.speed+' · '+MODE[remembered.mode]+' · Drehen '+(remembered.osc?'AN':'AUS');
  return true;
}
 const fmtUp=(s)=>{
 s=Math.max(0,Number(s)||0);const d=Math.floor(s/86400);s%=86400;
 const h=Math.floor(s/3600),m=Math.floor((s%3600)/60);
 return(d?d+'d ':'')+h+'h '+m+'m';
}
 const paintSlider=()=>{
 const v=+slp.value,pct=v/240*100;
 slp.style.setProperty('--trk',`linear-gradient(90deg,${v>0?'var(--air)':'var(--dim)'} ${pct}%,var(--line) ${pct}%)`);
 slp.style.setProperty('--knob',v>0?'var(--air)':'var(--dim)');
}
 const paintTimer=()=>{
 const live=S.speed>0,sec=currentSleepSec();
 $('#tcard').classList.toggle('off',!live);
 slp.disabled=!live||busy;
 $('#tval').classList.toggle('on',sec>0);
 $('#tval').innerHTML=sec>0?fmtClock(sec):'Aus';
 $('#trest').textContent=!live?'Ventilator ist aus':(sec>0?'Abschaltung in '+fmtClock(sec):'Läuft ohne Abschaltung');
 paintSlider();
}
 const paintManualPanel=()=>{
 const ms=$('#manualState');
 const displayMode=S.speed?S.mode:remembered.mode;
 const displayOsc=S.speed?S.osc:remembered.osc;
 if(ms)ms.textContent=S.speed
   ?('Stufe '+S.speed+' · '+MODE[displayMode]+' · Drehen '+(displayOsc?'AN':'AUS'))
   :('Aus · '+MODE[displayMode]+' · Drehen '+(displayOsc?'AN':'AUS'));

 document.querySelectorAll('#manualSpeedButtons button').forEach(b=>{
  b.classList.toggle('on',+b.dataset.manualSpeed===S.speed);
  b.disabled=busy||calibrating;
 });
 document.querySelectorAll('#manualModeButtons button').forEach(b=>{
  b.classList.toggle('on',+b.dataset.manualMode===displayMode);
  b.disabled=busy||calibrating;
 });
 const mo=$('#manualOsc');
 if(mo){
  mo.classList.toggle('on',displayOsc);
  mo.classList.toggle('pending',busy);
  mo.disabled=busy||calibrating;
 }
}
 const draw=()=>{
 paintManualPanel();
 const web=$('#detWebState');
 if(web)web.textContent=S.speed?('St'+S.speed+' / '+MODE[S.mode]+' / '+(S.osc?'AN':'AUS')):'AUS';
 document.querySelectorAll('.dial button').forEach(b=>{
  const t=+b.dataset.s;
  const active=(t===S.speed);
  b.classList.toggle('on',active);
  b.classList.toggle('pending',busy&&active);
  b.disabled=busy||(S.speed===0&&t>0);
 });
 $('#osc').classList.toggle('on',S.osc);
 $('#osc').classList.toggle('pending',busy);
 $('#osc').disabled=busy||!S.speed;
 $('#hdr').textContent=(S.speed?'Stufe '+S.speed+(S.mode?' · '+MODE[S.mode]:'')+(S.osc?' · dreht':''):'Aus');
 art.dataset.speed=S.speed;art.dataset.osc=S.osc?'1':'0';art.dataset.mode=S.speed?MKEY[S.mode]:'normal';
 document.querySelectorAll('#modes button').forEach(b=>{
  const act=(+b.dataset.m===S.mode);
  b.classList.toggle('on',act);
  b.classList.toggle('pending',busy&&act);
  b.disabled=busy||!S.speed;
 });
 $('#modes').classList.toggle('off',!S.speed);
 slp.value=S.sleep||0;
 paintTimer();
}
 const api=async (path,opts={})=>{
 const ctl=new AbortController(),to=setTimeout(()=>ctl.abort(),8000);
 try{
  const r=await fetch(path,{...opts,signal:ctl.signal,cache:'no-store'});
  clearTimeout(to);
  if(!r.ok)throw new Error('HTTP '+r.status);
  const ct=r.headers.get('content-type')||'';
  return ct.includes('application/json')?await r.json():await r.text();
 }catch(e){
  clearTimeout(to);
  throw e;
 }
}
let lastHealthOk=0;
// Statusabrufe strikt nacheinander; keine alte Antwort darf eine neuere
// Diagnoseanzeige wieder überschreiben.
let statusInFlight=false;
let statusPending=false;
let statusAbort=null;
let statusPollNotBefore=0;
let statusRequestSerial=0;
let statusAppliedSerial=0;

const markDiagSettling=()=>{
  if($('#detSpeed')) $('#detSpeed').textContent='stabilisiert…';
  if($('#detConf')) $('#detConf').textContent='—';
  if($('#detMode')) $('#detMode').textContent='stabilisiert…';
  if($('#detModeConf')) $('#detModeConf').textContent='—';
  if($('#detOsc')) $('#detOsc').textContent='stabilisiert…';
  if($('#detOscConf')) $('#detOscConf').textContent='—';
  if($('#detProfile')) $('#detProfile').textContent='—';
  if($('#detLivePct')) $('#detLivePct').textContent='—';
  if($('#detExpectedPct')) $('#detExpectedPct').textContent='wird aktualisiert…';
  if($('#detTracking')) $('#detTracking').textContent='stabilisiert…';
  if($('#detFit')) $('#detFit').textContent='—';
  if($('#detAge')) $('#detAge').textContent='—';
};

 const pollHealth=async ()=>{
 if(calibrating){
  $('#connDot').className='dot ok';
  $('#connTxt').textContent='Kalibrierung läuft…';
  return;
 }
 const ctl=new AbortController();
 const to=setTimeout(()=>ctl.abort(),2500);
 try{
  const r=await fetch('/api/health',{signal:ctl.signal,cache:'no-store'});
  clearTimeout(to);
  if(!r.ok)throw new Error('HTTP '+r.status);
  const x=await r.json();

  lastHealthOk=Date.now();
  online=true;
  $('#connDot').className='dot ok';
  $('#connTxt').textContent='ESP32 verbunden';

  $('#ip').textContent=x.ip||'—';
  $('#rssi').textContent=x.rssi!=null?x.rssi+' dBm':'—';
  $('#uptime').textContent=fmtUp(x.uptime);
  $('#build').textContent=x.build||'—';
  $('#fwBadge').textContent='FW '+(x.version||'—');
 }catch(e){
  clearTimeout(to);

  // Erst nach mehreren Sekunden ohne EINEN erfolgreichen Health-Check offline anzeigen.
  // Ein langsamer LED-Scan oder Lernvorgang darf die Anzeige nicht sofort rot machen.
  if(Date.now()-lastHealthOk > 9000){
   online=false;
   $('#connDot').className='dot err';
   $('#connTxt').textContent='ESP32 nicht erreichbar';
  }else{
   $('#connTxt').textContent='ESP32 beschäftigt…';
  }
 }
}

 const pollStatus=async ()=>{
 if(calibrating)return;
 if(Date.now()<statusPollNotBefore)return;
 if(statusInFlight){statusPending=true;return;}

 statusInFlight=true;
 const req=++statusRequestSerial;
 statusAbort=new AbortController();
 const ctl=statusAbort;
 const to=setTimeout(()=>ctl.abort(),5000);

 try{
  const r=await fetch('/api/status',{signal:ctl.signal,cache:'no-store'});
  clearTimeout(to);
  if(!r.ok)throw new Error('HTTP '+r.status);
  const x=await r.json();

  if(req<statusAppliedSerial)return;
  statusAppliedSerial=req;
  if(x.state){
    applyServerState(x.state);
    const ss=$('#stateSource');
    if(ss)ss.textContent='Web-/Sollzustand · Rev '+(x.state.revision||lastStateRevision);
  }
  if(x.thresholds && $('#thrNow')){
    $('#thrNow').textContent=x.thresholds.join(' · ');
  }
  if(x.offLearned!==undefined && $('#calOff')){
    $('#calOff').textContent = x.offLearned ? '✓ gelernt' : 'nicht gelernt';
  }
  if($('#calCombo')){
    $('#calCombo').textContent = x.recognitionModel==='FINAL_18P'&&x.combo18Learned ? ('✓ 18 von 18 · NORMAL-PRIORITY'+(x.oscLinearValid?' + OSC-LINEAR':'')) :
      (x.combo18Count ? (x.combo18Count+'/18 · nicht FINAL') : 'unvollständig');
  }
  // Kleine dauerhafte Übersicht unter "ESP32 & OTA".
  const c18=Number(x.combo18Count||0);
  const c9=Number(x.combo9Count||0);
  if($('#otaCal18')){
    $('#otaCal18').textContent = c18===18 ? '✓ 18/18 geladen' : ('⚠ '+c18+'/18 geladen');
  }
  if($('#otaCal9')){
    $('#otaCal9').textContent = c9===9 ? '✓ 9/9 geladen' : (c9+'/9');
  }
  if($('#otaOffProfile')){
    $('#otaOffProfile').textContent = x.offLearned ? '✓ geladen' : '⚠ fehlt';
  }
  if($('#otaModel')){
    const model=x.recognitionModel||'';
    $('#otaModel').textContent =
      model==='FINAL_18P' ? ('✓ FINAL 18P · NORMAL-PRIORITY'+(x.oscLinearValid?' + OSC-LINEAR':'')+' aktiv') :
      model==='FALLBACK_9P' ? '⚠ 9P-Fallback aktiv' :
      model==='NEUKALIBRIERUNG' ? '⚠ Finale Analyse erforderlich' :
      '⚠ Einzelprofile aktiv';
  }
  if($('#otaStorage')){
    const slots=Number(x.calSlots||0);
    $('#otaStorage').textContent = x.comboStorage!=='AB_CRC_NVS' ? '⚠ neue Kalibrierung nötig' :
      (slots>=2?'✓ A/B + CRC · 2/2':'⚠ CRC gültig · nur 1/2 Slots');
  }
  if($('#otaCalSeq')){const crc=Number(x.calCrc||0);$('#otaCalSeq').textContent=x.calSequence?('Gen '+x.calSequence+' · CRC '+crc.toString(16).toUpperCase().padStart(8,'0')):'—';}
  if($('#ledSync')){
    const modelOk=x.recognitionModel==='FINAL_18P';
    const syncOk=modelOk;
    $('#ledSync').disabled=busy||!syncOk;
    $('#ledSync').title=syncOk
      ?'Manueller 3-Batch-Abgleich · NORMAL priorisiert · globaler 18P-Score ist nur Diagnose'
      :'Erst finales Kalibrierungsmodell laden';
  }
  if(x.calibration){
    $('#cal1').textContent=x.calibration.s1?'✓ gelernt':'nicht gelernt';
    $('#cal2').textContent=x.calibration.s2?'✓ gelernt':'nicht gelernt';
    $('#cal3').textContent=x.calibration.s3?'✓ gelernt':'nicht gelernt';
    $('#detSpeed').textContent=x.calibration.settling?'stabilisiert…':(x.calibration.detected?('Speed '+x.calibration.detected+(S.speed===0?' (bei AUS ignoriert)':'')):'—');
    $('#detConf').textContent=x.calibration.detected?(Number(x.calibration.confidence).toFixed(0)+' %'):'—';
    if(x.calibration.detectedOff){
      $('#detSpeed').textContent='Aus';
      $('#detConf').textContent='LEDs sehr niedrig';
    }
    $('#calNormal').textContent=x.calibration.normal?'✓ gelernt':'nicht gelernt';
    $('#calBreeze').textContent=x.calibration.breeze?'✓ gelernt':'nicht gelernt';
    $('#calNight').textContent=x.calibration.night?'✓ gelernt':'nicht gelernt';
    const mn=['Normal','Breeze','Night'];
    if($('#detWebState')) $('#detWebState').textContent=S.speed?('St'+S.speed+' / '+mn[S.mode]+' / '+(S.osc?'AN':'AUS')):'AUS';
    if($('#detTracking')){
      $('#detTracking').textContent=x.recognitionModel!=='FINAL_18P'?'nicht verfügbar':
        (x.calibration.settling?'stabilisiert…':(x.calibration.trackingMatch?'✓ passt zum Web-Soll':'⚠ Abweichung'));
    }
    if($('#detFit')){
      const wf=Number(x.calibration.webFit||0),gf=Number(x.calibration.globalFit||0);
      $('#detFit').textContent=x.calibration.settling?'—':('Web-Soll '+wf.toFixed(0)+' % · 18P '+gf.toFixed(0)+' %');
    }
    if($('#detAge')){
      const age=Number(x.calibration.ageMs||0);
      $('#detAge').textContent=x.calibration.settling?'—':(age<1000?age+' ms':(age/1000).toFixed(1)+' s');
    }
    $('#detMode').textContent=x.calibration.settling?'stabilisiert…':(x.calibration.detectedMode>=0?mn[x.calibration.detectedMode]:'—');
    $('#detModeConf').textContent=x.calibration.detectedMode>=0?(Number(x.calibration.modeConfidence).toFixed(0)+' %'):'—';
    if($('#detOsc')) $('#detOsc').textContent=x.calibration.settling?'stabilisiert…':
      (x.calibration.detectedOsc>=0?(x.calibration.detectedOsc?'AN':'AUS'):'—');
    if($('#detOscConf')) $('#detOscConf').textContent=x.calibration.detectedOsc>=0?
      (Number(x.calibration.oscConfidence).toFixed(0)+' %'):'—';
    if($('#detProfile')){
      const ds=Number(x.calibration.globalSpeed||0);
      const dm=Number(x.calibration.globalMode);
      const doo=Number(x.calibration.globalOsc);
      $('#detProfile').textContent=(ds>=1&&ds<=3&&dm>=0&&dm<=2&&doo>=0)?
        ('St'+ds+' / '+mn[dm]+' / '+(doo?'AN':'AUS')):'—';
    }
    if($('#detLivePct')){
      const p=x.calibration.livePct||[];
      $('#detLivePct').textContent=x.calibration.settling?'—':(p.length===5?p.map(v=>Number(v).toFixed(1)).join(' · '):'—');
    }
    if($('#detExpectedPct')){
      const p=x.calibration.expectedPct||[];
      $('#detExpectedPct').textContent=x.calibration.expectedValid&&p.length===5?
        p.map(v=>Number(v).toFixed(1)).join(' · '):'—';
    }
  }
  draw();

  // Wenn der ESP noch Hintergrundfenster sammelt, zeitnah erneut fragen,
  // statt auf den normalen 1,6-s-Takt zu warten.
  if(x.calibration && x.calibration.settling && S.speed>0)
    setTimeout(pollStatus,1100);
 }catch(e){
  clearTimeout(to);
 }finally{
  if(statusAbort===ctl)statusAbort=null;
  statusInFlight=false;
  if(statusPending){
    statusPending=false;
    setTimeout(pollStatus,60);
  }
 }
}
 const post=async (path,obj)=>{
 return api(path,{method:'POST',headers:{'Content-Type':'application/json'},body:JSON.stringify(obj||{})});
}
let queued=null;
 const run=async (action,optimistic=null,diagSettleMs=0)=>{
 if(busy){ queued={action,optimistic,diagSettleMs}; return; }

 const before={...S},beforeSleepSyncAt=sleepSyncAt;
 if(statusAbort){
   try{statusAbort.abort();}catch(e){}
   statusAbort=null;
 }
 statusPending=false;

 if(optimistic){
  try{optimistic();}catch(e){}
 }

 if(diagSettleMs>0){
   statusPollNotBefore=Date.now()+250;
   markDiagSettling();
 }else{
   statusPollNotBefore=Date.now()+120;
 }

 busy=true;
 draw();

 try{
  const result=await action();
  if(result&&result.state)applyServerState(result.state);
 }catch(e){
  console.log(e);
  S={...before};sleepSyncAt=beforeSleepSyncAt;
  statusPollNotBefore=0;
  setTimeout(pollStatus,80);
 }finally{
  busy=false;
  draw();

  const q=queued; queued=null;
  if(q){
    run(q.action,q.optimistic,q.diagSettleMs||0);
  }else{
    const wait=Math.max(80,statusPollNotBefore-Date.now()+30);
    setTimeout(pollStatus,wait);
  }
 }
}

document.querySelectorAll('.dial button').forEach(b=>b.onclick=()=>{
 const t=+b.dataset.s;

 // Im AUS-Zustand ist ausschließlich An/Aus bedienbar.
 // Erst einschalten, danach Speed 1/2/3 auswählen.
 if(S.speed===0 && t>0)return;

 if(t===0){
   const wasOn=S.speed>0;
   run(
    ()=>post('/api/power',{}),
    ()=>{
      if(wasOn){
        S.speed=0;
        S.osc=false;
        S.mode=0;
        S.sleep=0;
        S.sleepSec=0;sleepSyncAt=Date.now();
      }else{
        // Die Fan-Platine behaelt beim normalen AUS->AN Speed/Modus/Drehen.
        // Deshalb alle drei gemerkten Dimensionen sofort korrekt darstellen;
        // die Serverantwort bestaetigt denselben autoritativen Zustand danach.
        S.speed=remembered.speed;
        S.mode=remembered.mode;
        S.osc=remembered.osc;
        S.sleep=0;
        S.sleepSec=0;
        sleepSyncAt=Date.now();
      }
    },
    5400
   );
   return;
 }

 if(t===S.speed)return;

 run(
   ()=>post('/api/speed',{target:t}),
   ()=>{S.speed=t;},
   3400
 );
});
document.querySelectorAll('#modes button').forEach(b=>b.onclick=()=>{
 const t=+b.dataset.m;
 if(!S.speed||t===S.mode)return;

 run(
   ()=>post('/api/mode',{target:t}),
   ()=>{S.mode=t;},
   4400
 );
});
$('#osc').onclick=()=>{
 if(!S.speed)return;
 const turningOn=!S.osc;
 run(
   ()=>post('/api/osc',{}),
   ()=>{S.osc=!S.osc;},
   turningOn?8600:5000
 );
};

// Nur den internen/Web-Zustand korrigieren. KEIN physischer Tastendruck.
// Das ist fuer Bedienung direkt am Ventilator gedacht.
document.querySelectorAll('#manualSpeedButtons button').forEach(b=>b.onclick=()=>{
 const target=+b.dataset.manualSpeed;
 const mode=S.speed?S.mode:remembered.mode;
 const osc=S.speed?S.osc:remembered.osc;

 run(
   ()=>post('/api/manual-state',{speed:target,mode,osc:osc?1:0}),
   ()=>{
    if(target===0){
      remembered.mode=mode;
      remembered.osc=osc;
      S.speed=0;S.osc=false;S.mode=0;S.sleep=0;S.sleepSec=0;sleepSyncAt=Date.now();
    }else{
      S.speed=target;
      S.mode=mode;
      S.osc=osc;
      remembered.speed=target;
      remembered.mode=mode;
      remembered.osc=osc;
    }
   },
   900
 );
});

document.querySelectorAll('#manualModeButtons button').forEach(b=>b.onclick=()=>{
 const target=+b.dataset.manualMode;
 const speed=S.speed;
 const osc=S.speed?S.osc:remembered.osc;
 run(
   ()=>post('/api/manual-state',{speed,mode:target,osc:osc?1:0}),
   ()=>{
    if(speed){
      S.mode=target;
      remembered.speed=speed;
      remembered.mode=target;
      remembered.osc=osc;
    }else{
      remembered.mode=target;
      remembered.osc=osc;
    }
   },
   900
 );
});

$('#manualOsc').onclick=()=>{
 const speed=S.speed;
 const mode=S.speed?S.mode:remembered.mode;
 const currentOsc=S.speed?S.osc:remembered.osc;
 const targetOsc=!currentOsc;

 run(
   ()=>post('/api/manual-state',{speed,mode,osc:targetOsc?1:0}),
   ()=>{
    if(speed){
      S.osc=targetOsc;
      remembered.speed=speed;
      remembered.mode=mode;
      remembered.osc=targetOsc;
    }else{
      remembered.mode=mode;
      remembered.osc=targetOsc;
    }
   },
   900
 );
};

slp.oninput=()=>{
 const preview=+slp.value;
 S.sleep=preview;
 S.sleepSec=preview*60;
 sleepSyncAt=Date.now();
 paintTimer();
};
slp.onchange=()=>{
 const target=+slp.value;
 // oninput hat bereits eine Vorschau in S geschrieben. Fuer die generische
 // Rollback-Logik zuerst den letzten SERVER-bestaetigten Timer rekonstruieren.
 const elapsed=Math.max(0,(Date.now()-confirmedSleepAt)/1000);
 const prevSec=Math.max(0,Math.ceil(confirmedSleepSec-elapsed));
 S.sleep=prevSec?Math.ceil(prevSec/60):0;
 S.sleepSec=prevSec;
 sleepSyncAt=Date.now();
 run(
   ()=>post('/api/timer',{minutes:target}),
   ()=>{S.sleep=target;S.sleepSec=target*60;sleepSyncAt=Date.now();}
 );
};

$('#ledSync').onclick=async()=>{
 const btn=$('#ledSync');
 const old=btn.textContent;
 if(btn.disabled)return;
 btn.disabled=true;btn.textContent='3× Normal-Prioritäts-Abgleich…';
 try{
  const ctl=new AbortController();
  const to=setTimeout(()=>ctl.abort(),45000);
  const rr=await fetch('/api/sync-from-leds',{
    method:'POST',
    headers:{'Content-Type':'application/json'},
    body:'{}',
    signal:ctl.signal,
    cache:'no-store'
  });
  clearTimeout(to);
  const txt=await rr.text();
  if(!rr.ok)throw new Error(txt||('HTTP '+rr.status));
  const x=JSON.parse(txt);
  if(x&&x.state)applyServerState(x.state);
  draw();
  btn.textContent=x.detectedOff?'Erkannt: Ventilator AUS':('Status übernommen · Speed '+(x.speed||'?')+' · '+(x.modeName||'Modus')+' · Drehen '+(x.osc?'AN':'AUS'));
  setTimeout(pollStatus,180);
 }catch(e){
  btn.textContent='Abgleich fehlgeschlagen';
  setTimeout(pollStatus,250);
 }
 setTimeout(()=>{btn.textContent=old;btn.disabled=false;},2200);
};





 const learnSpeed=async (n)=>{
 calibrating=true;
 const msg=$('#calMsg');
 msg.textContent='Lerne Speed '+n+'… bitte einige Sekunden nichts umschalten.';
 const ctl=new AbortController();
 const timeout=setTimeout(()=>ctl.abort(),70000);
 try{
  const r=await fetch('/api/learn-speed',{
   method:'POST',
   headers:{'Content-Type':'application/json'},
   body:JSON.stringify({speed:n}),
   signal:ctl.signal,
   cache:'no-store'
  });
  clearTimeout(timeout);
  const t=await r.text();
  if(!r.ok)throw new Error(t||('HTTP '+r.status));
  msg.textContent='Speed '+n+' wurde erfolgreich gelernt und gespeichert.';
  setTimeout(pollStatus,200);
 }catch(e){
  clearTimeout(timeout);
  msg.textContent=e.name==='AbortError'
   ?'Lernen dauert zu lange / Verbindung unterbrochen.'
   :'Lernen fehlgeschlagen: '+e.message;
  setTimeout(pollStatus,500);
 }finally{
  calibrating=false;
  setTimeout(pollHealth,100);
 }
}
$('#learn1').onclick=()=>learnSpeed(1);
$('#learn2').onclick=()=>learnSpeed(2);
$('#learn3').onclick=()=>learnSpeed(3);
$('#learnOff').onclick=async()=>{
 const b=$('#learnOff'); b.disabled=true; const alt=b.textContent;
 b.textContent='Messe…'; calibrating=true;
 try{
  const r=await post('/api/learn-off',{});
  if(r&&r.state)applyServerState(r.state);
  b.textContent = r&&r.ok ? 'Aus-Zustand gelernt' : 'Fehlgeschlagen';
  draw();
 }catch(e){ b.textContent='Fehler · Ventilator wirklich AUS?'; }
 calibrating=false;
 setTimeout(()=>{b.textContent=alt;b.disabled=false;pollStatus();},1800);
};

 const learnMode=async (n,label)=>{
 calibrating=true;
 const msg=$('#calMsg');
 msg.textContent='Lerne '+label+'… bitte einige Sekunden nichts umschalten.';
 const ctl=new AbortController();
 const timeout=setTimeout(()=>ctl.abort(),70000);
 try{
  const r=await fetch('/api/learn-mode',{
   method:'POST',
   headers:{'Content-Type':'application/json'},
   body:JSON.stringify({mode:n}),
   signal:ctl.signal,
   cache:'no-store'
  });
  clearTimeout(timeout);
  const t=await r.text();
  if(!r.ok)throw new Error(t||('HTTP '+r.status));
  msg.textContent=label+' wurde erfolgreich gelernt und gespeichert.';
  setTimeout(pollStatus,200);
 }catch(e){
  clearTimeout(timeout);
  msg.textContent=e.name==='AbortError'?'Lernen dauert zu lange / Verbindung unterbrochen.':'Lernen fehlgeschlagen: '+e.message;
  setTimeout(pollStatus,500);
 }finally{
  calibrating=false;
  setTimeout(pollHealth,100);
 }
}
$('#learnNormal').onclick=()=>learnMode(0,'Normal');
$('#learnBreeze').onclick=()=>learnMode(1,'Breeze');
$('#learnNight').onclick=()=>learnMode(2,'Night');





$('#forgetSpeedCal').onclick=async()=>{
 const msg=$('#calMsg');
 if(!confirm('Speed-Kalibrierung für Stufe 1, 2 und 3 wirklich löschen?')) return;
 msg.textContent='Speed-Kalibrierung wird gelöscht…';
 try{
  await post('/api/forget-speed-calibration',{});
  msg.textContent='Speed-Kalibrierung gelöscht. Speed 1–3 können neu angelernt werden.';
  setTimeout(pollStatus,200);
 }catch(e){
  msg.textContent='Löschen der Speed-Kalibrierung fehlgeschlagen.';
 }
};

$('#forgetModeCal').onclick=async()=>{
 const msg=$('#calMsg');
 if(!confirm('Modus-Kalibrierung für Normal, Breeze und Night wirklich löschen?')) return;
 msg.textContent='Modus-Kalibrierung wird gelöscht…';
 try{
  await post('/api/forget-mode-calibration',{});
  msg.textContent='Modus-Kalibrierung gelöscht. Normal, Breeze und Night können neu angelernt werden.';
  setTimeout(pollStatus,200);
 }catch(e){
  msg.textContent='Löschen der Modus-Kalibrierung fehlgeschlagen.';
 }
};

$('#backupExport').onclick=async()=>{
 const msg=$('#backupMsg');
 msg.textContent='Backup wird erstellt…';
 try{
  const r=await fetch('/api/backup/export',{cache:'no-store'});
  if(!r.ok)throw new Error('HTTP '+r.status);
  const blob=await r.blob();
  const a=document.createElement('a');
  const url=URL.createObjectURL(blob);
  a.href=url;
  a.download='ventilator-efficient-balanced-v6-backup.json';
  document.body.appendChild(a);
  a.click();
  a.remove();
  URL.revokeObjectURL(url);
  msg.textContent='Backup exportiert.';
 }catch(e){
  msg.textContent='Export fehlgeschlagen: '+e.message;
 }
};

$('#backupImport').onclick=async()=>{
 const msg=$('#backupMsg');
 const f=$('#backupFile').files[0];
 if(!f){msg.textContent='Bitte zuerst eine Backup-JSON auswählen.';return;}
 msg.textContent='Backup wird importiert…';
 try{
  const txt=await f.text();
  const r=await fetch('/api/backup/import',{
   method:'POST',
   headers:{'Content-Type':'application/json'},
   body:txt
  });
  const t=await r.text();
  if(!r.ok)throw new Error(t||('HTTP '+r.status));
  const x=JSON.parse(t);
  if(x&&x.state)applyServerState(x.state);
  draw();
  msg.textContent='Backup erfolgreich importiert und CRC-verifiziert.';
  setTimeout(pollStatus,180);
 }catch(e){
  msg.textContent='Import fehlgeschlagen: '+e.message;
 }
};

$('#otaForm').onsubmit=async e=>{
 e.preventDefault();const f=$('#otaFile').files[0];if(!f)return;
 $('#otaMsg').textContent='Upload läuft…';
 try{
  const fd=new FormData();fd.append('firmware',f,f.name);
  const r=await fetch('/update',{method:'POST',body:fd});
  const t=await r.text();if(!r.ok)throw new Error(t);
  $('#otaMsg').textContent='Update erfolgreich. ESP32 startet neu…';
  setTimeout(()=>location.reload(),6500);
 }catch(err){$('#otaMsg').textContent='OTA fehlgeschlagen: '+err.message;}
};

 const showTab=(cfg)=>{
 document.getElementById('viewMain').hidden = cfg;
 document.getElementById('viewCfg').hidden = !cfg;
 if(cfg){
  // Alle Einstellungs-Panels zugeklappt zeigen - jedes Mal.
  document.querySelectorAll('#viewCfg details.panel').forEach(d=>d.open=false);
 }else{
  // Manuelles Setzen auf der Steuerungsseite immer zugeklappt starten.
  const mp=document.getElementById('manualStatePanel');
  if(mp)mp.open=false;
 }
 document.getElementById('tabMain').classList.toggle('on',!cfg);
 document.getElementById('tabCfg').classList.toggle('on',cfg);
 window.scrollTo(0,0);
 try{location.hash = cfg?'#einstellungen':'';}catch(e){}
}
document.getElementById('tabMain').onclick=()=>showTab(false);
document.getElementById('tabCfg').onclick=()=>showTab(true);
if(location.hash==='#einstellungen') showTab(true);

setInterval(pollHealth,3000);
setInterval(pollStatus,1600);
setTimeout(pollHealth,100);
setTimeout(pollStatus,350);
setInterval(paintTimer,1000);
draw();
</script></body></html>

)HTML";

const char* pinName(uint8_t pin) {
  if(pin==PIN_POWER) return "POWER";
  if(pin==PIN_SPEED) return "SPEED";
  if(pin==PIN_OSC)   return "OSC";
  if(pin==PIN_MODE)  return "MODE";
  return "?";
}

void pulsePin(uint8_t pin, uint8_t count=1) {
  count = constrain(count, 1, 8);
  Serial.printf("[TASTE] %s  x%u  (GPIO%u)\n", pinName(pin), count, pin);
  for(uint8_t i=0;i<count;i++) {
    digitalWrite(pin,HIGH);
    delay(PRESS_MS);
    digitalWrite(pin,LOW);
    if(i+1<count) delay(GAP_MS);
  }
}

int jsonInt(const String& body,const char* key,int fallback=-1) {
  // substring() wuerde bei jedem Aufruf den Rest des Bodys auf den Heap kopieren.
  // strtol arbeitet direkt auf dem Puffer und kann zusaetzlich melden,
  // ob ueberhaupt eine Zahl dastand.
  String needle=String("\"")+key+"\":";
  int p=body.indexOf(needle);
  if(p<0) return fallback;
  p+=needle.length();
  const char* start=body.c_str()+p;
  char* end=nullptr;
  long v=strtol(start,&end,10);
  if(end==start) return fallback;          // keine Ziffer gefunden
  return (int)v;
}

void cancelTimer() {
  timerDeadlineMs=0;
  state.sleepMin=0;
}

void powerOff() {
  if(!fanIsOn)return;

#if ENABLE_LED_FEEDBACK
  // Falls der Ventilator am Originaltaster bereits ausgeschaltet wurde,
  // keinen zweiten Power-Impuls senden. Die Messung ist absichtlich robust.
  FbStats cur[5];
  sampleProfileAverage(cur,4,30);
  if(ledsLookOff(cur)) {
    Serial.println("[POWER] physisch bereits AUS -> nur Softwarezustand korrigiert");

    fanIsOn=false;
    state.speed=0;
    state.osc=false;
    state.mode=0;
    cancelTimer();

    ledDetectReadyMs=0;
    resetStableDiagnostic();

    startupSyncUntilMs=0;
    startupSyncReadyMs=0;
    startupSpeedCandidate=0;
    startupSpeedHits=0;
    startupModeCandidate=-1;
    startupModeHits=0;
    manualLedSyncRequested=false;
    startupScanDone=false;

    if(!suppressFanStateSave) {
      bumpStateRevision();
      saveFanState();
    }
    return;
  }
#endif

  if(state.speed>=1&&state.speed<=3)state.lastSpeed=state.speed;
  state.lastOsc=state.osc;
  state.lastMode=state.mode;

  Serial.printf("[POWER] AUS  (gemerkt: Stufe %u, Drehen %s, Modus %u)\n",
                state.lastSpeed,state.lastOsc?"an":"aus",state.lastMode);

  pulsePin(PIN_POWER);

  fanIsOn=false;
  state.speed=0;
  state.osc=false;
  state.mode=0;
  cancelTimer();

  ledDetectReadyMs=0;
  resetStableDiagnostic();

  startupSyncUntilMs=0;
  startupSyncReadyMs=0;
  startupSpeedCandidate=0;
  startupSpeedHits=0;
  startupModeCandidate=-1;
  startupModeHits=0;
  manualLedSyncRequested=false;
  startupScanDone=false;

  if(!suppressFanStateSave) {
    bumpStateRevision();
    saveFanState(); // powerOn=false wird jetzt ebenfalls persistent gespeichert
  }
}


void powerOffFromTimer() {
  if(!fanIsOn)return;

  // Timer nutzt ausschliesslich den verbindlichen Web-/Befehlszustand.
  if(state.speed>=1&&state.speed<=3)state.lastSpeed=state.speed;
  state.lastOsc=state.osc;
  state.lastMode=state.mode;

  Serial.printf("[TIMER] AUS merke: Stufe %u, Drehen %s, Modus %u\n",
                state.lastSpeed,state.lastOsc?"an":"aus",state.lastMode);

  pulsePin(PIN_POWER);

  fanIsOn=false;
  state.speed=0;
  state.osc=false;
  state.mode=0;
  cancelTimer();

  ledDetectReadyMs=0;
  resetStableDiagnostic();
  startupSyncUntilMs=0;
  startupSyncReadyMs=0;
  startupScanDone=true;
  manualLedSyncRequested=false;

  bumpStateRevision();
  saveFanState();
}

void togglePower() {
  if(!fanIsOn) {
    Serial.printf("[POWER] EIN  (bekannter Zustand: Stufe %u, Drehen %s, Modus %u)\n",
                  state.lastSpeed,state.lastOsc?"an":"aus",state.lastMode);

    pulsePin(PIN_POWER);
    fanIsOn=true;

    // Bei normalem AUS->AN bewahrt die Fan-Platine ihren Zustand.
    state.speed=state.lastSpeed;
    state.osc=state.lastOsc;
    state.mode=state.lastMode;

    startupSyncReadyMs=0;
    startupSyncUntilMs=0;
    startupScanDone=true;
    startupSpeedCandidate=0;
    startupSpeedHits=0;
    startupModeCandidate=-1;
    startupModeHits=0;

    // Wenn Drehen bereits als letzter Zustand AN war, braucht der Motor
    // dieselbe lange Beruhigungszeit wie nach einem expliziten OSC-Befehl.
    armLedDiagnostic(state.osc?8000UL:LED_DETECT_SETTLE_MS);

    if(!suppressFanStateSave) {
      bumpStateRevision();
      saveFanState(); // wichtig fuer OTA-/Software-Neustart bei laufendem Fan
    }

    Serial.println("[STATE] Web-/Befehlszustand verbindlich; LED = Diagnose/Manuell-Sync");
  } else {
    powerOff();
  }
}


// Eine bewusste Bedienung ueber das Webinterface ist maßgeblich.
// Sie beendet einen noch laufenden Startscan, damit die LED-Erkennung
// den gerade gewaehlten Zustand nicht wieder ueberschreibt. Der Abgleich
// aus den LEDs bleibt ueber den Knopf "Status jetzt aus LED uebernehmen"
// jederzeit moeglich.
void endStartupScan(const char* grund) {
  if(startupScanDone && startupSyncUntilMs == 0) return;
  startupScanDone       = true;
  startupSyncUntilMs    = 0;
  startupSyncReadyMs    = 0;
  startupSpeedCandidate = 0;
  startupSpeedHits      = 0;
  startupModeCandidate  = -1;
  startupModeHits       = 0;
  Serial.printf("[SCAN] Startscan beendet (%s)\n", grund);
}

void setSpeed(uint8_t target) {
  target=constrain(target,(uint8_t)0,(uint8_t)3);

  if(target==0) {
    powerOff();
    return;
  }
  if(!fanIsOn)return;
  if(target==state.speed)return;

  endStartupScan("Speed ueber Web gewaehlt");

  uint8_t presses=(target+3-state.speed)%3;
  Serial.printf("[SPEED] %u -> %u  (%u Impulse)\n",state.speed,target,presses);
  if(presses)pulsePin(PIN_SPEED,presses);

  state.speed=target;
  state.lastSpeed=target;

  // Physische Stufenumschaltung braucht kurz Ruhe; danach neue Fenster.
  armLedDiagnostic(3000UL);

  if(!suppressFanStateSave) {
    bumpStateRevision();
    saveFanState();
  }
}

void setMode(uint8_t target) {
  target=constrain(target,(uint8_t)0,(uint8_t)2);
  if(!fanIsOn || target==state.mode)return;

  endStartupScan("Modus ueber Web gewaehlt");

  uint8_t presses=(target+3-state.mode)%3;
  Serial.printf("[MODE] %u -> %u  (%u Impulse)\n",state.mode,target,presses);
  if(presses)pulsePin(PIN_MODE,presses);

  state.mode=target;
  state.lastMode=target;

  armLedDiagnostic(4000UL);

  if(!suppressFanStateSave) {
    bumpStateRevision();
    saveFanState();
  }
}

void toggleOsc() {
  if(!fanIsOn)return;

  endStartupScan("Drehen ueber Web geschaltet");

  bool target=!state.osc;
  Serial.printf("[OSC] %s -> %s\n",state.osc?"AN":"AUS",target?"AN":"AUS");

  pulsePin(PIN_OSC);
  state.osc=target;
  state.lastOsc=target;

  // Motor/Mechanik: AN deutlich laenger als AUS.
  armLedDiagnostic(target?8000UL:4500UL);

  if(!suppressFanStateSave) {
    bumpStateRevision();
    saveFanState();
  }
}







#if ENABLE_LED_FEEDBACK

// Alte fancal2/fancal3/fancal4-Lade-/Savepfade sind absichtlich entfernt.
// FINAL_EFFICIENT_BALANCED_V6 + OSC-LINEAR nutzt den kompakten fancal10 A/B+CRC-Speicher.

void invalidateCombinedProfiles() {
  for(int sp=0;sp<3;sp++)
    for(int md=0;md<3;md++) {
      comboSig[sp][md].valid=false;
      for(int os=0;os<2;os++)comboOscSig[sp][md][os].valid=false;
    }

  comboWValid=false;
  comboRichValid=false;
  comboGlobalSyncSafe=false;
  comboOscLinValid=false;
  comboLevelAlpha=0.0f;
  memset(comboRichPctQ,0,sizeof(comboRichPctQ));
  memset(comboOscLinW,0,sizeof(comboOscLinW));
  for(int md=0;md<3;md++){comboOscLinScale[md]=1.0f;comboOscLinBias[md]=0.0f;}
  for(int ch=0;ch<5;ch++)
    for(int q=0;q<RICH_CDF_LEVELS;q++)
      comboRichW[ch][q]=1.0f/(5.0f*RICH_CDF_LEVELS);
  comboShape=0.0f;
  comboMeanAlpha=0.0f;
  comboFitLimit=12.0f;
  for(int ch=0;ch<5;ch++) {
    comboW[ch]=1.0f;
    comboMeanW[ch]=1.0f;
  }

  if(!suppressCalibrationSave && !saveCompactComboCalibration(false))
    Serial.println("[CAL-NVS] WARNUNG: invalidierte Kalibrierung nicht dauerhaft gespeichert");
}


bool comboComplete() {
  for(int sp=0; sp<3; sp++)
    for(int md=0; md<3; md++)
      if(!comboSig[sp][md].valid) return false;
  return true;
}

// -------------------- Robuster Kalibrierungsspeicher A/B + CRC --------------------
// Zwei kompakte Slots statt hunderter einzelner NVS-Keys:
// - jeder Slot enthaelt die komplette Modellgeneration
// - CRC32 erkennt stille Korruption
// - Sequenznummer waehlt beim Boot den neuesten gueltigen Slot
// - beim Speichern bleibt der vorige Slot als Rueckfall erhalten
constexpr uint32_t COMPACT_COMBO_MAGIC=0x46363330UL; // "F630"
constexpr uint16_t COMPACT_COMBO_VERSION=9;         // FINAL_EFFICIENT_BALANCED_V6 + OSC_LINEAR_V1
constexpr const char* CAL_NVS_NS="fancal10";
constexpr const char* CAL_SLOT_A="A";
constexpr const char* CAL_SLOT_B="B";

uint32_t calStoreSequence=0;
uint32_t calStoreCrc=0;
uint8_t calStoreValidSlots=0;

struct CompactComboStore {
  uint32_t magic;
  uint16_t version;
  uint16_t bytes;
  uint32_t sequence;
  uint32_t crc32;

  uint8_t samplerVersion;
  uint8_t weightsValid;
  uint8_t reserved[2];

  int32_t thresholds[5];

  LearnedProfile speed[3];
  LearnedProfile mode[3];
  LearnedProfile off;
  LearnedProfile combo9[3][3];
  LearnedProfile combo18[3][3][2];

  float weights[5];
  float shape;

  float meanWeights[5];
  float meanAlpha;
  float levelAlpha;

  float richWeights[5][RICH_CDF_LEVELS];
  uint16_t richPctQ[3][3][2][5][RICH_CDF_LEVELS];
  uint8_t richValid;
  uint8_t globalSyncSafe;
  uint8_t richReserved[2];

  int16_t oscLinW[3][OSC_LINEAR_FEATURES];
  float oscLinScale[3];
  float oscLinBias[3];
  uint8_t oscLinValid;
  uint8_t oscLinReserved[3];

  float fitLimit;
};

// STACK-SAFE v6.4.5:
// CompactComboStore liegt knapp unter 4 KiB. Zwei oder mehr lokale Instanzen
// auf dem Arduino-loopTask-Stack koennen den ESP32-S3 bereits beim Booten
// zuruecksetzen, noch bevor WLAN/Webserver gestartet werden.
// Deshalb liegen die drei Arbeitsbuffer dauerhaft im BSS/RAM statt auf dem Stack.
static CompactComboStore calStoreBufA;
static CompactComboStore calStoreBufB;
static CompactComboStore calStoreVerifyBuf;

// Explizite Prototypen auch fuer den kompakten NVS-Datentyp.
uint32_t compactStoreCrc(const CompactComboStore& src);
void fillCompactComboStore(CompactComboStore& b);
bool validateCompactStore(CompactComboStore& b);
bool readCompactSlot(const char* key,CompactComboStore& out);
bool writeCompactSlot(const char* key,const CompactComboStore& b);

static_assert(sizeof(CompactComboStore)<4096,"CompactComboStore unexpectedly large");

uint32_t calibrationCrc32(const uint8_t* data,size_t len) {
  uint32_t crc=0xFFFFFFFFu;
  for(size_t i=0;i<len;i++) {
    crc^=data[i];
    for(uint8_t b=0;b<8;b++)
      crc=(crc>>1)^((crc&1u)?0xEDB88320u:0u);
  }
  return crc^0xFFFFFFFFu;
}

uint32_t compactStoreCrc(const CompactComboStore& src) {
  // Kein 4-KiB-Temp-Objekt auf dem Stack: CRC direkt ueber die Quellstruktur,
  // wobei das crc32-Feld logisch als vier Nullbytes behandelt wird.
  const uint8_t* p=(const uint8_t*)&src;
  const size_t crcOff=(const uint8_t*)&src.crc32-p;
  uint32_t crc=0xFFFFFFFFu;

  for(size_t i=0;i<sizeof(src);i++) {
    uint8_t v=(i>=crcOff && i<crcOff+sizeof(src.crc32))?0u:p[i];
    crc^=v;
    for(uint8_t b=0;b<8;b++)
      crc=(crc>>1)^((crc&1u)?0xEDB88320u:0u);
  }
  return crc^0xFFFFFFFFu;
}

void fillCompactComboStore(CompactComboStore& b) {
  memset(&b,0,sizeof(b));
  b.magic=COMPACT_COMBO_MAGIC;
  b.version=COMPACT_COMBO_VERSION;
  b.bytes=sizeof(CompactComboStore);
  b.sequence=calStoreSequence+1;
  b.samplerVersion=CAL_SAMPLER_VERSION;
  b.weightsValid=comboWValid?1:0;

  for(int ch=0;ch<5;ch++)b.thresholds[ch]=fbThresholds[ch];

  memcpy(b.speed,speedSig,sizeof(speedSig));
  memcpy(b.mode,modeSig,sizeof(modeSig));
  memcpy(&b.off,&offSig,sizeof(offSig));
  memcpy(b.combo9,comboSig,sizeof(comboSig));
  memcpy(b.combo18,comboOscSig,sizeof(comboOscSig));

  for(int ch=0;ch<5;ch++) {
    b.weights[ch]=comboW[ch];
    b.meanWeights[ch]=comboMeanW[ch];
  }
  b.shape=comboShape;
  b.meanAlpha=comboMeanAlpha;
  b.levelAlpha=comboLevelAlpha;
  memcpy(b.richWeights,comboRichW,sizeof(comboRichW));
  memcpy(b.richPctQ,comboRichPctQ,sizeof(comboRichPctQ));
  b.richValid=comboRichValid?1:0;
  b.globalSyncSafe=comboGlobalSyncSafe?1:0;
  memcpy(b.oscLinW,comboOscLinW,sizeof(comboOscLinW));
  memcpy(b.oscLinScale,comboOscLinScale,sizeof(comboOscLinScale));
  memcpy(b.oscLinBias,comboOscLinBias,sizeof(comboOscLinBias));
  b.oscLinValid=comboOscLinValid?1:0;
  b.fitLimit=comboFitLimit;

  b.crc32=compactStoreCrc(b);
}

bool validateCompactStore(CompactComboStore& b) {
  if(b.magic!=COMPACT_COMBO_MAGIC ||
     b.version!=COMPACT_COMBO_VERSION ||
     b.bytes!=sizeof(CompactComboStore) ||
     b.samplerVersion!=CAL_SAMPLER_VERSION)return false;

  uint32_t stored=b.crc32;
  return stored!=0 && stored==compactStoreCrc(b);
}

bool readCompactSlot(const char* key,CompactComboStore& out) {
  memset(&out,0,sizeof(out));

  prefs.begin(CAL_NVS_NS,true);
  size_t len=prefs.getBytesLength(key);
  size_t got=(len==sizeof(out))?prefs.getBytes(key,&out,sizeof(out)):0;
  prefs.end();

  return got==sizeof(out)&&validateCompactStore(out);
}

bool writeCompactSlot(const char* key,const CompactComboStore& b) {
  prefs.begin(CAL_NVS_NS,false);
  size_t n=prefs.putBytes(key,&b,sizeof(b));
  prefs.end();

  if(n!=sizeof(b)) {
    Serial.printf("[CAL-NVS] Slot %s write failed: %u/%u bytes\n",
                  key,(unsigned)n,(unsigned)sizeof(b));
    return false;
  }

  // Verifikation ebenfalls ueber globalen BSS-Buffer statt 4-KiB-Stackobjekt.
  if(!readCompactSlot(key,calStoreVerifyBuf) ||
     calStoreVerifyBuf.sequence!=b.sequence ||
     calStoreVerifyBuf.crc32!=b.crc32) {
    Serial.printf("[CAL-NVS] Slot %s verify FEHLER\n",key);
    return false;
  }

  Serial.printf("[CAL-NVS] Slot %s verifiziert · Seq %lu · %u Bytes\n",
                key,(unsigned long)b.sequence,(unsigned)sizeof(b));
  return true;
}

bool sequenceNewer(uint32_t a,uint32_t b) {
  return (int32_t)(a-b)>0;
}

void reclaimLegacyCalibrationNvs() {
  const char* oldNs[]={"fancal2","fancal3","fancal4","fancal5","fancal6","fancal7","fancal8","fancal9","fanfb"};
  for(const char* ns:oldNs) {
    prefs.begin(ns,false);
    prefs.clear();
    prefs.end();
  }
}

bool saveCompactComboCalibration(bool reclaimLegacy) {
  // Nur globale Arbeitsbuffer verwenden: keine mehreren ~4-KiB-Strukturen
  // auf dem loopTask-Stack.
  bool va=readCompactSlot(CAL_SLOT_A,calStoreBufA);
  bool vb=readCompactSlot(CAL_SLOT_B,calStoreBufB);
  bool hadCurrentGeneration=va||vb;

  const char* target=CAL_SLOT_A;
  uint32_t newest=calStoreSequence;

  if(va && (!vb || sequenceNewer(calStoreBufA.sequence,calStoreBufB.sequence))) {
    newest=calStoreBufA.sequence;
    target=CAL_SLOT_B;
  } else if(vb) {
    newest=calStoreBufB.sequence;
    target=CAL_SLOT_A;
  }

  calStoreSequence=newest;

  CompactComboStore& out=(strcmp(target,CAL_SLOT_A)==0)?calStoreBufA:calStoreBufB;
  fillCompactComboStore(out);

  bool ok=writeCompactSlot(target,out);

  if(!ok && reclaimLegacy) {
    Serial.println("[CAL-NVS] Speicher knapp -> alte Kalibrierungs-Namespaces werden freigegeben");
    reclaimLegacyCalibrationNvs();
    ok=writeCompactSlot(target,out);
  }

  compactComboLastSaveOk=ok;
  if(!ok)return false;

  calStoreSequence=out.sequence;
  calStoreCrc=out.crc32;
  compactComboLoaded=true;
  calibrationSamplerCurrent=true;

  // Bei der ersten Speicherung eine zweite CRC-verifizierte Kopie erzeugen.
  // Der jeweils andere globale Slotbuffer kann dafuer wiederverwendet werden.
  if(!hadCurrentGeneration) {
    const char* mirror=(strcmp(target,CAL_SLOT_A)==0)?CAL_SLOT_B:CAL_SLOT_A;
    CompactComboStore& second=(strcmp(mirror,CAL_SLOT_A)==0)?calStoreBufA:calStoreBufB;
    fillCompactComboStore(second);
    bool mirrorOk=writeCompactSlot(mirror,second);
    if(!mirrorOk && reclaimLegacy) {
      reclaimLegacyCalibrationNvs();
      mirrorOk=writeCompactSlot(mirror,second);
    }
    if(mirrorOk) {
      calStoreSequence=second.sequence;
      calStoreCrc=second.crc32;
    } else {
      Serial.println("[CAL-NVS] WARNUNG: erster Slot OK, A/B-Spiegelung fehlgeschlagen");
    }
  }

  // Redundanzzustand neu lesen/validieren, weiterhin ohne Stack-Grossobjekte.
  bool nva=readCompactSlot(CAL_SLOT_A,calStoreBufA);
  bool nvb=readCompactSlot(CAL_SLOT_B,calStoreBufB);
  calStoreValidSlots=(uint8_t)(nva?1:0)+(uint8_t)(nvb?1:0);

  CompactComboStore* best=nullptr;
  if(nva&&nvb)best=sequenceNewer(calStoreBufA.sequence,calStoreBufB.sequence)?&calStoreBufA:&calStoreBufB;
  else if(nva)best=&calStoreBufA;
  else if(nvb)best=&calStoreBufB;

  if(best) {
    calStoreSequence=best->sequence;
    calStoreCrc=best->crc32;
  }

  if(reclaimLegacy)reclaimLegacyCalibrationNvs();
  return calStoreValidSlots>=1;
}

bool loadCompactComboCalibration() {
  // Bootpfad stack-sicher: beide knapp 4-KiB-Slots liegen im globalen BSS.
  bool va=readCompactSlot(CAL_SLOT_A,calStoreBufA);
  bool vb=readCompactSlot(CAL_SLOT_B,calStoreBufB);

  if(!va && !vb) {
    compactComboLoaded=false;
    compactComboLastSaveOk=false;
    calibrationSamplerCurrent=false;
    calStoreSequence=0;
    calStoreCrc=0;
    calStoreValidSlots=0;
    return false;
  }

  CompactComboStore* best=nullptr;
  if(va && vb)best=sequenceNewer(calStoreBufA.sequence,calStoreBufB.sequence)?&calStoreBufA:&calStoreBufB;
  else best=va?&calStoreBufA:&calStoreBufB;

  for(int ch=0;ch<5;ch++)fbThresholds[ch]=constrain((int)best->thresholds[ch],0,4095);

  memcpy(speedSig,best->speed,sizeof(speedSig));
  memcpy(modeSig,best->mode,sizeof(modeSig));
  memcpy(&offSig,&best->off,sizeof(offSig));
  memcpy(comboSig,best->combo9,sizeof(comboSig));
  memcpy(comboOscSig,best->combo18,sizeof(comboOscSig));

  for(int ch=0;ch<5;ch++) {
    comboW[ch]=best->weights[ch];
    comboMeanW[ch]=best->meanWeights[ch];
  }
  comboShape=constrain(best->shape,0.0f,1.0f);
  // Cross-Boot-Robustheit: der 6.4.3-Rohdatensatz war mit 16/4 im
  // unabhaengigen Holdout mindestens so gut wie 64/16, ist aber deutlich
  // weniger empfindlich gegen sessionweite ADC-Pegelverschiebungen.
  comboMeanAlpha=constrain(best->meanAlpha,0.0f,16.0f);
  comboLevelAlpha=constrain(best->levelAlpha,0.0f,4.0f);
  memcpy(comboRichW,best->richWeights,sizeof(comboRichW));
  memcpy(comboRichPctQ,best->richPctQ,sizeof(comboRichPctQ));
  comboRichValid=best->richValid!=0;
  comboGlobalSyncSafe=best->globalSyncSafe!=0;
  memcpy(comboOscLinW,best->oscLinW,sizeof(comboOscLinW));
  memcpy(comboOscLinScale,best->oscLinScale,sizeof(comboOscLinScale));
  memcpy(comboOscLinBias,best->oscLinBias,sizeof(comboOscLinBias));
  comboOscLinValid=best->oscLinValid!=0;
  comboFitLimit=max(best->fitLimit,0.25f);
  comboWValid=best->weightsValid!=0;
  if(!comboRichValid) {
    compactComboLoaded=false;
    calibrationSamplerCurrent=false;
    return false;
  }

  calStoreSequence=best->sequence;
  calStoreCrc=best->crc32;
  calStoreValidSlots=(uint8_t)(va?1:0)+(uint8_t)(vb?1:0);
  compactComboLoaded=true;
  compactComboLastSaveOk=true;
  calibrationSamplerCurrent=true;

  Serial.printf("[CAL-NVS] FINAL geladen · Seq %lu · Speed=%u/%u/%u · Mode=%u/%u/%u · AUS=%u · 9P=%u/9 · 18P=%u/18\n",
                (unsigned long)calStoreSequence,
                speedSig[0].valid?1:0,speedSig[1].valid?1:0,speedSig[2].valid?1:0,
                modeSig[0].valid?1:0,modeSig[1].valid?1:0,modeSig[2].valid?1:0,
                offSig.valid?1:0,comboValidCount(),comboOscValidCount());
  return true;
}

void clearCompactComboCalibration() {
  prefs.begin(CAL_NVS_NS,false);
  prefs.clear();
  prefs.end();

  compactComboLoaded=false;
  compactComboLastSaveOk=false;
  calibrationSamplerCurrent=false;
  calStoreSequence=0;
  calStoreCrc=0;
  calStoreValidSlots=0;
  comboRichValid=false;
  comboGlobalSyncSafe=false;
  comboOscLinValid=false;
  comboLevelAlpha=0.0f;
  memset(comboRichPctQ,0,sizeof(comboRichPctQ));
  memset(comboOscLinW,0,sizeof(comboOscLinW));
  for(int md=0;md<3;md++){comboOscLinScale[md]=1.0f;comboOscLinBias[md]=0.0f;}
}


void invalidateRuntimeCalibrationForSampler() {
  // Alte Modellgenerationen werden im RAM bewusst NICHT weiterverwendet.
  for(int s=0;s<3;s++){speedSig[s].valid=false;modeSig[s].valid=false;}
  offSig.valid=false;
  for(int sp=0;sp<3;sp++)
    for(int md=0;md<3;md++) {
      comboSig[sp][md].valid=false;
      for(int os=0;os<2;os++)comboOscSig[sp][md][os].valid=false;
    }

  comboWValid=false;
  comboRichValid=false;
  comboGlobalSyncSafe=false;
  comboLevelAlpha=0.0f;
  memset(comboRichPctQ,0,sizeof(comboRichPctQ));
  for(int ch=0;ch<5;ch++)
    for(int q=0;q<RICH_CDF_LEVELS;q++)comboRichW[ch][q]=1.0f/(5.0f*RICH_CDF_LEVELS);
  comboShape=0.0f;
  comboMeanAlpha=0.0f;
  comboFitLimit=12.0f;
  for(int ch=0;ch<5;ch++) {
    comboW[ch]=1.0f;
    comboMeanW[ch]=1.0f;
    fbThresholds[ch]=FB_DEFAULT_THR[ch];
  }

  compactComboLoaded=false;
  calibrationSamplerCurrent=false;
  calStoreSequence=0;
  calStoreCrc=0;
  calStoreValidSlots=0;
  resetStableDiagnostic();

  Serial.println("[CAL] Keine kompatible FINAL-RICH-CDF-Kalibrierung -> kompletter Messlauf erforderlich");
}

void saveOffCalibration() {
  if(!suppressCalibrationSave)
    saveCompactComboCalibration(false);
}

void loadOffCalibration() {
  prefs.begin("fancal2", true);
  offSig.valid = prefs.getBool("ov", false);
  for(int ch=0; ch<5; ch++) {
    String pk="op"+String(ch);
    String mk="om"+String(ch);
    offSig.avgPct[ch]  = prefs.getFloat(pk.c_str(), 0.0f);
    offSig.avgMean[ch] = prefs.getFloat(mk.c_str(), 0.0f);
  }
  prefs.end();
}

// Misst den aktuellen Zustand und legt ihn als AUS-Referenz ab.
bool learnOffSignature() {
#if ENABLE_LED_FEEDBACK
  FbStats cur[5];
  sampleProfileAverage(cur,10,55);

  for(int ch=0;ch<5;ch++) {
    offSig.avgPct[ch]=cur[ch].abovePct;
    offSig.avgMean[ch]=cur[ch].avg;
  }

  offSig.valid=true;
  if(!saveCompactComboCalibration(false)) {
    Serial.println("[CAL-NVS] WARNUNG: AUS-Profil nicht dauerhaft gespeichert");
    return false;
  }

  Serial.printf("[AUS] FINAL_EFFICIENT_BALANCED_V6-Profil: %.1f %.1f %.1f %.1f %.1f\n",
                offSig.avgPct[0],offSig.avgPct[1],offSig.avgPct[2],
                offSig.avgPct[3],offSig.avgPct[4]);
  return true;
#else
  return false;
#endif
}


void saveSpeedCalibration(int idx) {
  if(idx<0||idx>2)return;
  if(!suppressCalibrationSave)
    saveCompactComboCalibration(false);
}

void saveModeCalibration(int idx) {
  if(idx<0||idx>2)return;
  if(!suppressCalibrationSave)
    saveCompactComboCalibration(false);
}


float robustMedianOfMeans(float* v, int n) {
  // 6 Gruppen; Median der Gruppenmittelwerte unterdrueckt einzelne
  // Stoerfenster wesentlich besser als ein einfacher Gesamtmittelwert.
  const int G = 6;
  float gm[G] = {0,0,0,0,0,0};
  int gc[G] = {0,0,0,0,0,0};

  for(int i=0;i<n;i++) {
    int g = i % G;
    gm[g] += v[i];
    gc[g]++;
  }
  for(int g=0;g<G;g++) if(gc[g]) gm[g] /= gc[g];

  // kleine Insertion-Sortierung
  for(int i=1;i<G;i++) {
    float x=gm[i]; int j=i-1;
    while(j>=0 && gm[j] > x) { gm[j+1]=gm[j]; j--; }
    gm[j+1]=x;
  }
  return (gm[2] + gm[3]) * 0.5f;
}

bool learnProfile(LearnedProfile& p) {
  // Einzel-Lernen nutzt denselben FINAL_EFFICIENT_BALANCED_V6-Sampler wie die finale 18P-Analyse.
  constexpr int WINDOWS=12;
  double pct[5]={0,0,0,0,0};
  double meanv[5]={0,0,0,0,0};

  for(int w=0;w<WINDOWS;w++) {
    FbStats cur[5];
    sampleProfileWindow(cur);
    for(int ch=0;ch<5;ch++) {
      pct[ch]+=cur[ch].abovePct;
      meanv[ch]+=cur[ch].avg;
    }
    delay(45);
    yield();
  }

  for(int ch=0;ch<5;ch++) {
    p.avgPct[ch]=pct[ch]/WINDOWS;
    p.avgMean[ch]=meanv[ch]/WINDOWS;
  }
  p.valid=true;
  return true;
}

bool learnSpeedSignature(int speedNo) {
  if(speedNo<1 || speedNo>3)return false;
  int idx=speedNo-1;
  bool ok=learnProfile(speedSig[idx]);
  if(ok)saveSpeedCalibration(idx);
  return ok;
}

bool learnModeSignature(int modeNo) {
  if(modeNo<0 || modeNo>2)return false;
  bool ok=learnProfile(modeSig[modeNo]);
  if(ok)saveModeCalibration(modeNo);
  return ok;
}

float normalizedMean(const float means[5], int ch) {
  float sum = 0.0f;
  for(int i=0;i<5;i++) sum += means[i];
  if(sum < 1.0f) return 0.0f;
  return (means[ch] / sum) * 100.0f;
}

float currentNormalizedMean(const FbStats current[5], int ch) {
  float sum = 0.0f;
  for(int i=0;i<5;i++) sum += current[i].avg;
  if(sum < 1.0f) return 0.0f;
  return ((float)current[ch].avg / sum) * 100.0f;
}

float signatureDistanceWeighted(const LearnedProfile& sig,
                                const FbStats current[5],
                                const float weights[5]) {
  float d = 0.0f;

  for(int ch=0;ch<5;ch++) {
    // 1) Pulsanteil: relativ robust gegen globale Pegelverschiebungen.
    float dp = (float)current[ch].abovePct - sig.avgPct[ch];

    // 2) Normalisierter Mittelwert: betrachtet das Verhältnis der Kanäle
    //    zueinander statt absolute ADC-Pegel. Das macht die Erkennung
    //    unempfindlicher gegen Versorgungsschwankungen / gemeinsame Drift.
    float pMean = normalizedMean(sig.avgMean, ch);
    float cMean = currentNormalizedMean(current, ch);
    float dn = (cMean - pMean) * 2.0f;

    d += weights[ch] * (dp*dp + dn*dn);
  }

  return d;
}

int detectProfilesWeightedFromCurrent(LearnedProfile profiles[3],
                                      const FbStats cur[5],
                                      const float weights[5],
                                      float* confidenceOut) {
  float best = 1e30f;
  float second = 1e30f;
  int bestIdx = -1;

  for(int s=0;s<3;s++) {
    if(!profiles[s].valid) continue;

    float d = signatureDistanceWeighted(profiles[s], cur, weights);

    if(d < best) {
      second = best;
      best = d;
      bestIdx = s;
    } else if(d < second) {
      second = d;
    }
  }

  if(confidenceOut) {
    if(bestIdx < 0 || second >= 1e29f) {
      *confidenceOut = 0.0f;
    } else {
      // Kombination aus Abstand zum Zweitbesten und absoluter Match-Qualität.
      float margin = 1.0f - (best / (second + 0.0001f));
      if(margin < 0) margin = 0;
      if(margin > 1) margin = 1;

      float quality = 1.0f / (1.0f + sqrtf(best) / 90.0f);
      float c = margin * quality;
      if(c < 0) c = 0;
      if(c > 1) c = 1;
      *confidenceOut = c * 100.0f;
    }
  }

  return bestIdx;
}

// Kompatibilitätsfunktion für vorhandenen Code.
int detectProfilesFromCurrent(LearnedProfile profiles[3],
                              const FbStats cur[5],
                              float* confidenceOut) {
  const float equalWeights[5] = {1,1,1,1,1};
  return detectProfilesWeightedFromCurrent(profiles,cur,equalWeights,confidenceOut);
}

int detectProfiles(LearnedProfile profiles[3], float* confidenceOut) {
  FbStats cur[5];
  sampleProfileWindow(cur);
  const float equalWeights[5] = {1,1,1,1,1};
  return detectProfilesWeightedFromCurrent(profiles,cur,equalWeights,confidenceOut);
}

// Klassifiziert Stufe UND Modus in einem Schritt gegen alle neun Profile.
// Liefert -1, wenn nicht alle neun gelernt sind.
int detectCombo(const FbStats cur[5],int* speedOut,int* modeOut,
                float* speedConfOut,float* modeConfOut) {
  if(speedOut)*speedOut=0;
  if(modeOut)*modeOut=-1;
  if(speedConfOut)*speedConfOut=0.0f;
  if(modeConfOut)*modeConfOut=0.0f;
  if(!comboComplete())return -1;

  float dist[3][3];
  float best=1e30f;
  int bs=-1,bm=-1;

  for(int sp=0;sp<3;sp++)
    for(int md=0;md<3;md++) {
      float d=comboDistanceToProfile(comboSig[sp][md],cur);
      dist[sp][md]=d;
      if(d<best){best=d;bs=sp;bm=md;}
    }

  if(bs<0)return -1;

  float altSpeed=1e30f,altMode=1e30f;
  for(int sp=0;sp<3;sp++)
    for(int md=0;md<3;md++) {
      if(sp!=bs)altSpeed=min(altSpeed,dist[sp][md]);
      if(md!=bm)altMode=min(altMode,dist[sp][md]);
    }

  auto conf=[&](float other)->float{
    if(other>1e29f)return 0.0f;
    float rb=sqrtf(max(best,0.0f));
    float ro=sqrtf(max(other,0.0f));
    float margin=(ro>0.0001f)?((ro-rb)/ro):0.0f;
    margin=constrain(margin,0.0f,1.0f);
    return margin*(comboFitQualityPct(best)/100.0f)*100.0f;
  };

  if(speedOut)*speedOut=bs+1;
  if(modeOut)*modeOut=bm;
  if(speedConfOut)*speedConfOut=conf(altSpeed);
  if(modeConfOut)*modeConfOut=conf(altMode);
  return bs+1;
}


// Finale Klassifikation gegen alle 18 Profile.
// WICHTIG:
// Die Trennschaerfe-Analyse bewertet den Abstand zwischen VOLLSTAENDIGEN
// 18P-Zustaenden. Deshalb muss auch die Laufzeit-Erkennung EINEN globalen
// Gewinner aus den 18 Profilen waehlen.
//
// Eine getrennte Wahl von Speed/Modus/Drehen ist falsch: dabei koennen z.B.
// "Speed 3" aus einem Profil und "Drehen AUS" aus einem anderen Profil
// zusammengebaut werden, obwohl kein einziges 18P-Profil diese Kombination
// als besten Treffer hatte.
int detectComboOsc(const FbStats cur[5],
                   int* speedOut,int* modeOut,int* oscOut,
                   float* speedConfOut,float* modeConfOut,float* oscConfOut) {
  if(speedOut)*speedOut=0;
  if(modeOut)*modeOut=-1;
  if(oscOut)*oscOut=-1;
  if(speedConfOut)*speedConfOut=0.0f;
  if(modeConfOut)*modeConfOut=0.0f;
  if(oscConfOut)*oscConfOut=0.0f;
  if(!comboOscComplete() || !comboRichValid)return -1;

  float dist[3][3][2];
  float best=1e30f;
  int bs=-1,bm=-1,bo=-1;

  for(int sp=0;sp<3;sp++)
    for(int md=0;md<3;md++)
      for(int os=0;os<2;os++) {
        float d=comboRichDistanceToState(sp,md,os,cur);
        dist[sp][md][os]=d;
        if(d<best){best=d;bs=sp;bm=md;bo=os;}
      }

  if(bs<0)return -1;

  float altSpeed=1e30f,altMode=1e30f,altOsc=1e30f;
  for(int sp=0;sp<3;sp++)
    for(int md=0;md<3;md++)
      for(int os=0;os<2;os++) {
        float d=dist[sp][md][os];
        if(sp!=bs&&d<altSpeed)altSpeed=d;
        if(md!=bm&&d<altMode)altMode=d;
        if(os!=bo&&d<altOsc)altOsc=d;
      }

  auto conf=[&](float other)->float{
    if(other>1e29f)return 0.0f;
    float rb=sqrtf(max(best,0.0f));
    float ro=sqrtf(max(other,0.0f));
    float margin=(ro>0.0001f)?((ro-rb)/ro):0.0f;
    margin=constrain(margin,0.0f,1.0f);
    return margin*(comboFitQualityPct(best)/100.0f)*100.0f;
  };

  if(speedOut)*speedOut=bs+1;
  if(modeOut)*modeOut=bm;
  if(oscOut)*oscOut=bo;
  if(speedConfOut)*speedConfOut=conf(altSpeed);
  if(modeConfOut)*modeConfOut=conf(altMode);
  if(oscConfOut)*oscConfOut=conf(altOsc);
  return bs+1;
}


float comboRichDistanceToState(int sp,int md,int os,const FbStats cur[5]) {
  if(!comboRichValid || sp<0||sp>2||md<0||md>2||os<0||os>1)
    return 1e30f;

  float d=0.0f;

  for(int q=0;q<RICH_CDF_LEVELS;q++) {
    float tm=0.0f,rm=0.0f;
    for(int ch=0;ch<5;ch++) {
      tm+=cur[ch].cdfPct[q];
      rm+=richDecodePct(comboRichPctQ[sp][md][os][ch][q]);
    }
    tm/=5.0f;rm/=5.0f;

    for(int ch=0;ch<5;ch++) {
      float t=cur[ch].cdfPct[q]-comboShape*tm;
      float r=richDecodePct(comboRichPctQ[sp][md][os][ch][q])-comboShape*rm;
      float e=t-r;
      d+=comboRichW[ch][q]*e*e;
    }
  }

  float pMean[5],cMean[5];
  normalizedMeanFeature(comboOscSig[sp][md][os].avgMean,pMean);
  normalizedMeanFeature(cur,cMean);
  for(int ch=0;ch<5;ch++) {
    float e=cMean[ch]-pMean[ch];
    d+=comboMeanAlpha*comboMeanW[ch]*e*e;
  }

  float pLevel=rawLevelFeature(comboOscSig[sp][md][os].avgMean);
  float cLevel=rawLevelFeature(cur);
  float el=cLevel-pLevel;
  d+=comboLevelAlpha*el*el;

  return d;
}

float comboOscLinearScore(int sp,int md,const FbStats cur[5]) {
  if(!comboOscLinValid || sp<0||sp>2||md<0||md>2)return 0.0f;

  double acc=comboOscLinBias[md];
  int fi=0;
  const float scale=comboOscLinScale[md];

  for(int ch=0;ch<5;ch++)
    for(int q=0;q<RICH_CDF_LEVELS;q++,fi++)
      acc+=(double)scale*(double)comboOscLinW[md][fi]*(double)cur[ch].cdfPct[q];

  for(int s=0;s<3;s++,fi++)
    if(s==sp)acc+=(double)scale*(double)comboOscLinW[md][fi];

  return (float)acc;
}

int comboOscLinearDetect(int sp,int md,const FbStats cur[5],float* confidenceOut) {
  if(confidenceOut)*confidenceOut=0.0f;
  if(!comboOscLinValid || sp<0||sp>2||md<0||md>2)return -1;

  float score=comboOscLinearScore(sp,md,cur);
  // Logistische Distanz zur Entscheidungsgrenze. Ein kleiner Wert ist bewusst
  // nur geringe Diagnose-Sicherheit, auch wenn die Klasse selbst eindeutig ist.
  float z=constrain(score,-12.0f,12.0f);
  float p=1.0f/(1.0f+expf(-z));
  if(confidenceOut)*confidenceOut=fabsf(p-0.5f)*200.0f;
  return score>=0.0f?1:0;
}

// Cross-Boot-robuste Formmetrik fuer die fuenf Live-LED-%.
// Gemeinsamer Offset und gemeinsame positive Skalierung verschwinden durch
// Zentrieren + Normieren. Die gespeicherten Rich-CDF-Profile bleiben erhalten.
float comboPctShapeDistanceToProfile(const LearnedProfile& p,const FbStats cur[5]) {
  if(!p.valid)return 1e30f;

  float mp=0.0f,mc=0.0f;
  for(int ch=0;ch<5;ch++){mp+=p.avgPct[ch];mc+=cur[ch].abovePct;}
  mp*=0.2f;mc*=0.2f;

  float dot=0.0f,np=0.0f,nc=0.0f;
  for(int ch=0;ch<5;ch++) {
    float a=p.avgPct[ch]-mp;
    float b=cur[ch].abovePct-mc;
    dot+=a*b;np+=a*a;nc+=b*b;
  }

  if(np<0.0001f || nc<0.0001f)return 2.0f;
  float corr=dot/sqrtf(np*nc);
  corr=constrain(corr,-1.0f,1.0f);
  return 1.0f-corr;
}

// Speed-/Modus-Formvergleich ignoriert absichtlich Drehen. Dadurch kann eine
// unstabile AUS/AN-Amplitude Stufe oder Modus nicht alleine umwerfen.
float comboPctShapeDistanceToSpeedMode(int sp,int md,const FbStats cur[5]) {
  if(sp<0||sp>2||md<0||md>2)return 1e30f;
  float d0=comboPctShapeDistanceToProfile(comboOscSig[sp][md][0],cur);
  float d1=comboPctShapeDistanceToProfile(comboOscSig[sp][md][1],cur);
  return min(d0,d1);
}

static float pctShapeConfidence(float best,float second) {
  if(second>1e29f)return 0.0f;
  return constrain((second-best)/(second+0.02f),0.0f,1.0f)*100.0f;
}

static float pctShapeFit(float d) {
  // Absichtlich tolerant gegen die beobachtete Cross-Boot-Verschiebung.
  return constrain(1.0f-d/0.25f,0.0f,1.0f)*100.0f;
}

int detectSpeedPctShapeForMode(int md,const FbStats cur[5],float* confidenceOut,float* fitOut) {
  if(confidenceOut)*confidenceOut=0.0f;
  if(fitOut)*fitOut=0.0f;
  if(md<0||md>2 || !comboOscComplete())return -1;

  float d[3];
  for(int sp=0;sp<3;sp++)d[sp]=comboPctShapeDistanceToSpeedMode(sp,md,cur);
  int best=0;if(d[1]<d[best])best=1;if(d[2]<d[best])best=2;
  float second=1e30f;for(int sp=0;sp<3;sp++)if(sp!=best)second=min(second,d[sp]);

  if(confidenceOut)*confidenceOut=pctShapeConfidence(d[best],second);
  if(fitOut)*fitOut=pctShapeFit(d[best]);
  return best;
}

int detectModePctShapeForSpeed(int sp,const FbStats cur[5],float* confidenceOut,float* fitOut) {
  if(confidenceOut)*confidenceOut=0.0f;
  if(fitOut)*fitOut=0.0f;
  if(sp<0||sp>2 || !comboOscComplete())return -1;

  float d[3];
  for(int md=0;md<3;md++)d[md]=comboPctShapeDistanceToSpeedMode(sp,md,cur);
  int best=0;if(d[1]<d[best])best=1;if(d[2]<d[best])best=2;
  float second=1e30f;for(int md=0;md<3;md++)if(md!=best)second=min(second,d[md]);

  if(confidenceOut)*confidenceOut=pctShapeConfidence(d[best],second);
  if(fitOut)*fitOut=pctShapeFit(d[best]);
  return best;
}


// Manueller Zustandsabgleich: sammelt nur cross-boot-robuste Merkmale.
// Speed/Modus basieren auf der relativen 5-Kanal-Form. Drehen verwendet
// bevorzugt OSC-LINEAR. Der globale 18P-Fit wird hier absichtlich NICHT
// als Freigabebedingung benutzt.
void manualSyncAccumulateBatch(const FbStats cur[5],
                               float pairDist[3][3],
                               uint8_t speedVotes[3][3],
                               uint8_t oscOnVotes[3][3],
                               uint8_t oscOffVotes[3][3],
                               float oscScoreSum[3][3]) {
  float d[3][3];

  for(int sp=0;sp<3;sp++) {
    for(int md=0;md<3;md++) {
      d[sp][md]=comboPctShapeDistanceToSpeedMode(sp,md,cur);
      pairDist[sp][md]+=d[sp][md];

      float oscScore=0.0f;
      if(comboOscLinValid) {
        oscScore=comboOscLinearScore(sp,md,cur);
      } else {
        float d0=comboRichDistanceToState(sp,md,0,cur);
        float d1=comboRichDistanceToState(sp,md,1,cur);
        // Positiv bedeutet AN, negativ AUS.
        oscScore=sqrtf(max(d0,0.0f))-sqrtf(max(d1,0.0f));
      }
      oscScoreSum[sp][md]+=oscScore;
      if(oscScore>=0.0f)oscOnVotes[sp][md]++;
      else oscOffVotes[sp][md]++;
    }
  }

  // Pro Modus eine Speed-Stimme. Dadurch koennen wir spaeter den bekannten
  // Web-Modus als Prior verwenden, ohne eine globale 18P-Entscheidung zu
  // erzwingen.
  for(int md=0;md<3;md++) {
    int bs=0;
    if(d[1][md]<d[bs][md])bs=1;
    if(d[2][md]<d[bs][md])bs=2;
    speedVotes[md][bs]++;
  }
}


float comboDistanceToProfile(const LearnedProfile& p,const FbStats cur[5]) {
  float pp[5],cc[5],pf[5],cf[5];
  for(int ch=0;ch<5;ch++){pp[ch]=p.avgPct[ch];cc[ch]=cur[ch].abovePct;}
  comboFeature(pp,comboShape,pf);
  comboFeature(cc,comboShape,cf);

  float pMean[5],cMean[5];
  normalizedMeanFeature(p.avgMean,pMean);
  normalizedMeanFeature(cur,cMean);

  float d=0.0f;
  for(int ch=0;ch<5;ch++) {
    float ePct=cf[ch]-pf[ch];
    float eMean=cMean[ch]-pMean[ch];

    float wp=comboWValid?comboW[ch]:1.0f;
    float wm=comboWValid?comboMeanW[ch]:1.0f;

    d += wp*ePct*ePct;
    d += comboMeanAlpha*wm*eMean*eMean;
  }
  return d;
}

float comboFitQualityPct(float distanceSq) {
  float root=sqrtf(max(distanceSq,0.0f));
  float lim=max(comboFitLimit,0.25f);

  // Innerhalb des per Holdout bestimmten Trainingsbereichs keine Strafe.
  if(root<=lim)return 100.0f;

  // Zwischen 1x und 2x Trainingsgrenze linear auf 0.
  float q=1.0f-(root-lim)/lim;
  return constrain(q,0.0f,1.0f)*100.0f;
}

float contextualConfidence(float best,float second) {
  if(second>1e29f)return 0.0f;

  float rb=sqrtf(max(best,0.0f));
  float rs=sqrtf(max(second,0.0f));
  float margin=(rs>0.0001f)?((rs-rb)/rs):0.0f;
  margin=constrain(margin,0.0f,1.0f);

  float fit=comboFitQualityPct(best)/100.0f;
  return margin*fit*100.0f;
}
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
void loop() {
  server.handleClient();
  analyzeStep();
  updateLedDiagnosticTask();

  // Eigener Timer: Taste4 des Ventilators bleibt komplett unbenutzt.
  if(timerDeadlineMs && (long)(millis()-timerDeadlineMs)>=0) {
    timerDeadlineMs=0;
    state.sleepMin=0;
    Serial.println("[TIMER] abgelaufen - schalte definiert ab");
    powerOffFromTimer();
  }

  if(timerDeadlineMs) {
    long remain=(long)(timerDeadlineMs-millis());
    state.sleepMin=remain>0 ? (remain+59999L)/60000L : 0;
  }

  // WLAN automatisch wieder verbinden; Fallback-AP bleibt dabei erreichbar.
  if(WiFi.status()!=WL_CONNECTED && millis()-lastWifiRetryMs>30000UL) {
    lastWifiRetryMs=millis();
    Serial.println("[NET] Reconnect-Versuch");
    WiFi.reconnect();
  }
  updateApFallback();
}
